mnorden81/RC-Multiswitch-ESP32-S3/docs/Hardware-Beschreibung_C3_S3.docx

# RC-Multiswitch – Hardware-Beschreibung

Schaltboards mit ESP32-C3 SuperMini und ESP32-S3-Zero · Stand 18.10.2026

# 1. Überblick

Das RC-Multiswitch ist ein 8-kanaliges Schaltmodul für RC-Anwendungen (Licht, Zusatzfunktionen, Sound-Trigger). Die Kanäle werden über das CRSF-Protokoll (420 000 Baud) vom Empfänger angesteuert. Ein TBD62083APG (Nachfolger des ULN2803A) schaltet gegen Masse (Low-Side) Lasten mit 5–12 V; ein ESP32 übernimmt Protokoll, Logik und Konfiguration (WLAN-Web-UI, Lua-Script).

Es gibt zwei Platinen-Varianten mit identischem Schalt-Teil:

Merkmal | Variante C3 | Variante S3
Controller-Modul | ESP32-C3 SuperMini | Waveshare ESP32-S3-Zero
Kern / UARTs | 1× RISC-V, UART0 + UART1 | 2× Xtensa, UART0/1/2
CRSF-Anschlüsse | UART A (Eingang) + UART B (weiter) | UART A (Eingang) + UART B + UART C (weiter)
PWM-Kanäle (LEDC) | 6 (Ausgang 7/8 nur digital) | 8 (alle Ausgänge PWM-fähig)
Status-LED | keine steuerbare (Onboard-LED IO8 = UB_RX) | WS2812 an IO21 nutzbar
BOOT-Taster | IO9 (am Modul) | IO0 (am Modul)
Platinenstand | fertig (KiCad 9) | aus C3-Platine portiert, Leiterbahnen nicht vollständig (20 offene Verbindungen)

# 2. Gemeinsame Funktionen

- Schaltstufe: TBD62083APG (DIP-18, gesockelt; ein ULN2803A passt weiterhin, gleiche Pinbelegung), 8 Kanäle, Open-Drain gegen GND, max. 500 mA je Kanal, Summe ca. 1,5 A. Interne Freilaufdioden an COM → VLOAD.
- Lastversorgung: CN2 (JST PH, 2-polig), 5–12 V, als VLOAD an COM des Treibers U2 und auf J1. TVS-Diode D1 P6KE18A schützt vor Spannungsspitzen.
- Logikversorgung: +5 V vom UART-A-Stecker CN1 (Pin 2); das ESP-Modul wird darüber versorgt. +5 V wird an die weiterführenden UART-Stecker durchgereicht.
- Kontroll-LEDs: LED1–8 mit R1–R8 je Kanal vom Steuersignal gegen GND – leuchtet, wenn der Kanal aktiv ist. Die Werte von R1–R8 legt der Anwender fest; eine Empfehlung ist auf der Platine aufgedruckt.
- Ausgänge: J1 (2×8-Stiftleiste, 2,54 mm): ungerade Pins = OUT1…OUT8 (nach Serienwiderstand R9–R16, Wert vom Anwender), gerade Pins = VLOAD.
- CRSF-Kette: Module lassen sich per UART durchschleifen (UART A Eingang, B/C Ausgang), siehe Firmware-Spezifikation.

# 3. Steckerbelegung

UART-Stecker (JST GH 4-polig, vertikal SMD) – CN1 = UART A, J5 = UART B, J6 = UART C (nur S3)

Pin | CN1 (A, Eingang) | J5 / J6 (B / C, weiter)
1 | GND | GND
2 | +5 V (Versorgung ein) | +5 V (durchgereicht)
3 | RX (ESP empfängt, vom Empfänger-TX) | TX (ESP sendet zum nächsten Modul)
4 | TX (ESP sendet zum Empfänger-RX) | RX (ESP empfängt vom nächsten Modul)

CN2 – Lastversorgung (JST PH 2-polig, vertikal)

Pin | Signal
1 | GND
2 | VLOAD (+5…12 V)

J1 – Ausgänge (2×8, 2,54 mm) und Kanal-Zuordnung

Kanal | Signal | GPIO C3 | GPIO S3 | U2-IN | U2-OUT | R aus | J1-Pin | LED / R-LED
1 | S0 | IO0 | IO11 | U2.8 | U2.11 | R16 | J1.15 | LED1 / R1
2 | S1 | IO1 | IO4 | U2.7 | U2.12 | R15 | J1.13 | LED2 / R2
3 | S2 | IO2 | IO5 | U2.6 | U2.13 | R14 | J1.11 | LED3 / R3
4 | S3 | IO3 | IO6 | U2.5 | U2.14 | R13 | J1.9 | LED4 / R4
5 | S4 | IO4 | IO10 | U2.4 | U2.15 | R12 | J1.7 | LED5 / R5
6 | S5 | IO5 | IO9 | U2.3 | U2.16 | R11 | J1.5 | LED6 / R6
7 | S6 | IO6 | IO8 | U2.2 | U2.17 | R10 | J1.3 | LED7 / R7
8 | S7 | IO7 | IO7 | U2.1 | U2.18 | R9 | J1.1 | LED8 / R8

Die geraden J1-Pins (2, 4, … 16) führen VLOAD; so kann eine Last direkt zwischen J1-Pin „OUTk“ und dem benachbarten VLOAD-Pin angeschlossen werden (Kanal k → J1-Pin 17−2k).

# 4. Variante C3 (ESP32-C3 SuperMini)

GPIO-Belegung C3

Signal | GPIO | Modul-Pad | Funktion
S0 | IO0 | U1.1 | Schaltausgang (Treiber-Eingang + LED) 1
S1 | IO1 | U1.2 | Schaltausgang (Treiber-Eingang + LED) 2
S2 | IO2 | U1.3 | Schaltausgang (Treiber-Eingang + LED) 3
S3 | IO3 | U1.4 | Schaltausgang (Treiber-Eingang + LED) 4
S4 | IO4 | U1.5 | Schaltausgang (Treiber-Eingang + LED) 5
S5 | IO5 | U1.9 | Schaltausgang (Treiber-Eingang + LED) 6
S6 | IO6 | U1.10 | Schaltausgang (Treiber-Eingang + LED) 7
S7 | IO7 | U1.11 | Schaltausgang (Treiber-Eingang + LED) 8
UA_RX | IO20 | U1.15 | CRSF-UART A – RX
UA_TX | IO21 | U1.16 | CRSF-UART A – TX
UB_TX | IO10 | U1.14 | CRSF-UART B – TX
UB_RX | IO8 | U1.12 | CRSF-UART B – RX

Stückliste C3

Referenz | Anz. | Wert | Footprint
CN1 | 1 | UART A | JST_GH_BM04B-GHS-TBT_1x04-1MP_P1.25mm_Vertical
CN2 | 1 | 5-12V | JST_PH_B2B-PH-K_1x02_P2.00mm_Vertical
D1 | 1 | P6KE18A | D_DO-15_P12.70mm_Horizontal
J1 | 1 | Ausgaenge | PinHeader_2x08_P2.54mm_Vertical
J5 | 1 | UART B | JST_GH_BM04B-GHS-TBT_1x04-1MP_P1.25mm_Vertical
LED1–LED8 | 8 | LED | LED_D3.0mm
R1–R16 | 16 | vom Anwender | R_Axial_DIN0207_L6.3mm_D2.5mm_P7.62mm_Horizontal
U1 | 1 | ESP32-C3 SuperMini | ESP32-C3-SuperMini_THT
U2 | 1 | TBD62083APG | DIP-18_W7.62mm_Socket

## Besonderheiten C3

- Nur 6 LEDC-Kanäle: Ausgang 7 und 8 (IO6/IO7) können nur digital schalten bzw. softwareseitig getaktet werden.
- UART A = UART0-Standardpins (IO20 RX / IO21 TX): das Boot-Log des ROM erscheint kurz auf IO21 (UA_TX). Debug-Ausgaben der Firmware daher über USB-CDC.
- Onboard-LED (IO8) ist zugleich UB_RX – sie flackert mit UART-B-Daten und ist als Status-LED nicht verwendbar.
- Strapping-Pins: IO2 (Kanal 3), IO8 (UB_RX), IO9 (BOOT). Beim Reset sollten IO8 und IO9 high sein; IO2-Beschaltung (LED + Treiber-Eingang nach GND) beim ersten Test prüfen.
- Einkernig: CRSF-Verarbeitung, Weiterleitung und WLAN laufen auf demselben Kern.

# 5. Variante S3 (Waveshare ESP32-S3-Zero)

GPIO-Belegung S3

Signal | GPIO | Modul-Pad | Funktion
S0 | IO11 | U1.14 | Schaltausgang (Treiber-Eingang + LED) 1
S1 | IO4 | U1.7 | Schaltausgang (Treiber-Eingang + LED) 2
S2 | IO5 | U1.8 | Schaltausgang (Treiber-Eingang + LED) 3
S3 | IO6 | U1.9 | Schaltausgang (Treiber-Eingang + LED) 4
S4 | IO10 | U1.15 | Schaltausgang (Treiber-Eingang + LED) 5
S5 | IO9 | U1.16 | Schaltausgang (Treiber-Eingang + LED) 6
S6 | IO8 | U1.17 | Schaltausgang (Treiber-Eingang + LED) 7
S7 | IO7 | U1.18 | Schaltausgang (Treiber-Eingang + LED) 8
UA_RX | IO44 | U1.11 | CRSF-UART A – RX
UA_TX | IO43 | U1.10 | CRSF-UART A – TX
UB_TX | IO13 | U1.12 | CRSF-UART B – TX
UB_RX | IO12 | U1.13 | CRSF-UART B – RX
UC_TX | IO2 | U1.5 | CRSF-UART C – TX
UC_RX | IO1 | U1.4 | CRSF-UART C – RX

Stückliste S3

Referenz | Anz. | Wert | Footprint
CN1 | 1 | UART A | JST_GH_BM04B-GHS-TBT_1x04-1MP_P1.25mm_Vertical
CN2 | 1 | 5-12V | JST_PH_B2B-PH-K_1x02_P2.00mm_Vertical
D1 | 1 | P6KE18A | D_DO-15_P12.70mm_Horizontal
J1 | 1 | Ausgaenge | PinHeader_2x08_P2.54mm_Vertical
J5 | 1 | UART B | JST_GH_BM04B-GHS-TBT_1x04-1MP_P1.25mm_Vertical
J6 | 1 | UART C | JST_GH_BM04B-GHS-TBT_1x04-1MP_P1.25mm_Vertical
LED1–LED8 | 8 | LED | LED_D3.0mm
R1–R16 | 16 | vom Anwender | R_Axial_DIN0207_L6.3mm_D2.5mm_P7.62mm_Horizontal
U1 | 1 | ESP32-S3-Zero | ESP32-S3-Zero_THT
U2 | 1 | TBD62083APG | DIP-18_W7.62mm_Socket

## Besonderheiten S3

- 8 LEDC-Kanäle, zwei Kerne, drei UARTs (A = UART0 auf IO43/IO44, B = IO13/IO12, C = IO2/IO1).
- WS2812-RGB-LED auf IO21 als Status-LED nutzbar (kein Konflikt mit der Belegung).
- UART A = IO43/IO44: das Boot-Log erscheint auf IO43 (UA_TX).
- Strapping-Pins IO0 (BOOT-Taster), IO3, IO45, IO46 sind nicht belegt – keine Konflikte.
- USB (IO19/IO20) bleibt frei für Programmierung und USB-CDC-Debug.

# 6. Dimensionierung

## Strom und Spannung

- Schaltstrom: max. 500 mA je Kanal, Summe aller Kanäle ca. 1,5 A. Der TBD62083APG verliert nur ca. 0,2–0,4 V; beim ULN2803A sind es ca. 1,1–1,3 V bei 350 mA (ca. 0,4 W je Kanal), dann bei mehreren Kanälen mit hoher Last Derating prüfen.
- Serienwiderstände R9–R16 im Ausgang: kein Wert vorgegeben. Der Anwender legt sie passend zu Verbraucher und Lastspannung (5–12 V) aus, Strom und Verlustleistung beachten. Für Lasten ohne Vorwiderstand (z. B. Relais) eine Drahtbrücke einsetzen.
- Kontroll-LEDs: R1–R8 legt der Anwender fest. Die Empfehlung für 3,3 V ist auf der Platine aufgedruckt (Rot/Gelb 270 Ω, Grün 220 Ω, Blau/Weiß 56 Ω, ca. 5 mA).
- CN2 (JST PH): ca. 2 A je Kontakt; Summenstrom aller Lasten darauf beachten.

# 7. Stand und offene Punkte

- C3-Platine: fertig, in KiCad 9. Steckerfootprints derzeit JST GH vertikal SMD (CN2: PH vertikal); horizontale Varianten sind nicht umgesetzt.
- S3-Platine: Bauteile und Netze aus der C3-Platine übernommen, J6 (UART C) ergänzt; die Leitungen an U1 sind neu verlegt; DRC wurde in dieser Umgebung nicht durchgeführt.
- ERC/DRC: nicht in KiCad 9 geprüft (nur Netzlisten-Abgleich). Vor Fertigung ERC/DRC in KiCad durchführen.
- Pad-Zuordnung der Module (SuperMini, S3-Zero) vor dem Bestücken gegen das tatsächliche Modul prüfen.

RC-Multiswitch – Hardware-Beschreibung – Seite
