mnorden81/RC-Multiswitch-ESP32-S3/hardware/gehaeuse/Gehaeuse3D_Vorschau_gewinkelt.html

# Gehäuse Schaltmodul S3, gewinkelte Stiftleiste

Version für eine gewinkelte Stiftleiste 2×8 (2,54 mm) an J1. Die Stecker der 8 Ausgänge kommen seitlich durch die rechte Wand, der Deckel ist über J1 geschlossen. Platine RC-Multiswitch-ESP32-S3 NEG oder POS (Waveshare ESP32-S3-Zero, TBD62083APG bzw. TBD62783APG). Alle Maße stammen aus der KiCad-Datei, die Bauteilhöhen sind Annahmen (unten markiert).

Außen71,9 × 61,6

Höhe19,6 mm

Platine66,5 × 50,6

Ziehen = drehen · Mausrad/zwei Finger = zoomen · rechte Maustaste = schieben

Zustand Zu Deckel ab Explosion

Ansicht Schräg Links (USB, A, 5-12 V) Hinten (B, C) Rechts (Ausgänge) Oben Unten

Zeigen Platine Deckel Deckel durchsichtig

## Öffnungen

Wo | Wofür | Größe B × H
links | USB-C des S3-Zero, außen mit Tasche für dicke Stecker | 12,0 × 7,6
links | CN1 UART A (Empfänger) | 11,5 × 7,0
links | CN2 Last 5-12 V | 7,5 × 7,0
hinten | J5 UART B und J6 UART C (eine gemeinsame Öffnung) | 22,8 × 7,0
rechts | J1 gewinkelte Stiftleiste 2×8, 8 Stecker 2-polig nebeneinander | 21,5 × 6,2
Deckel | Fenster über dem S3-Zero (BOOT, RESET, RGB-LED) | 24,5 × 19,0
Deckel | 8 Lichtlöcher Kontroll-LEDs | Ø 3,4
Deckel | 4 Lüftungsschlitze über dem Treiber U2 | 1,4 × 19

## Annahmen, bitte prüfen

- S3-Zero direkt eingelötet auf normaler Stiftleiste (Unterkante 2,5 mm über der Platine), so bestätigt. In einer Buchsenleiste säße er ca. 11 mm hoch, dann müssten USB-Loch und Innenhöhe angepasst werden.
- Gewinkelte Leiste nach KiCad-Footprint PinHeader_2x08_P2.54mm_Horizontal: Kunststoff 5,1 mm hoch, steht ca. 0,1 mm über die Platinenkante, Pins ragen ca. 3,4 mm aus der Außenwand. Gelötet wird in die vorhandenen Löcher, die Platine bleibt unverändert. Oben liegen die Ausgänge, unten die gemeinsame Reihe (NEG: VLOAD, POS: GND).
- Innenhöhe 11 mm wie bei der stehenden Version. Am höchsten ist jetzt der Treiber U2 im Sockel (ca. 8 mm).
- Befestigung der Platine: Sie hat keine Montagelöcher. Sie liegt ringsum auf einem 1,2 mm Rand und 2 Stützen. Der Deckel drückt sie mit 9 kleinen Rippen am Rand fest. Ohne Schrauben durch die Platine.
- Kontroll-LEDs (3 mm) sitzen ca. 6 mm unter dem Deckel. Durch die Löcher sieht man sie gut leuchten.
- Lage von BOOT, RESET und RGB-LED auf dem S3-Zero steht nicht in der KiCad-Datei. Deshalb ein Fenster über dem ganzen Modul.
- JST-PH-Stecker liegend, ca. 6 mm hoch. Öffnungen 0,8 mm größer als das Gehäuse der Buchse.

## Drucken und Montieren

- Material PETG oder PLA. 0,2 mm Schicht, 3 Wände, 20 % Füllung.
- Unterteil mit dem Boden aufs Bett, Deckel mit der Oberseite aufs Bett (STL ist schon gedreht). Keine Stützen nötig.
- Platine einfach einlegen, Stecker zeigen zu den Öffnungen links, hinten und rechts (J1). Die Stecker für J1 erst nach dem Einlegen aufstecken.
- Deckel: 4 × Blechschraube 2,5 × 8 (Senkkopf) in die Dome in der vorderen und hinteren Wand.
- Einbau ins Modell: 4 Laschen mit 3,4 mm Loch am Boden für Schrauben oder Kabelbinder.
- Wandstärke 2,2 mm, Boden und Deckel 2,0 mm, 3 mm Luft unter der Platine für Lötstellen.

## Dateien

- Gehaeuse_Unterteil_gewinkelt.stl / .step
- Gehaeuse_Deckel_gewinkelt.stl / .step
- gehaeuse.py --gewinkelt (Quelle, CadQuery, alle Maße als Parameter oben in der Datei)

STEP lässt sich in Fusion 360, FreeCAD oder KiCad öffnen und weiter ändern.
