mnorden81/RC-Multiswitch-ESP32-S3/hardware/gehaeuse/Gehaeuse3D_Vorschau.html

# Gehäuse Schaltmodul S3

Unterteil und Deckel für die Platine RC-Multiswitch-ESP32-S3 (Waveshare ESP32-S3-Zero, ULN2803A, 8 Ausgänge). Alle Maße stammen aus der KiCad-Datei, die Bauteilhöhen sind Annahmen (unten markiert).

Außen71,9 × 61,6

Höhe19,6 mm

Platine66,5 × 50,6

Ziehen = drehen · Mausrad/zwei Finger = zoomen · rechte Maustaste = schieben

Zustand Zu Deckel ab Explosion

Ansicht Schräg Links (USB, A, 5-12 V) Hinten (B, C) Oben Unten

Zeigen Platine Deckel Deckel durchsichtig

## Öffnungen

Wo | Wofür | Größe B × H
links | USB-C des S3-Zero, außen mit Tasche für dicke Stecker | 12,0 × 7,6
links | CN1 UART A (Empfänger) | 11,5 × 7,0
links | CN2 Last 5-12 V | 7,5 × 7,0
hinten | J5 UART B und J6 UART C (eine gemeinsame Öffnung) | 22,8 × 7,0
Deckel | J1 Stiftleiste 2×8, Stecker von oben | 6,9 × 22,1
Deckel | Fenster über dem S3-Zero (BOOT, RESET, RGB-LED) | 24,5 × 19,0
Deckel | 8 Lichtlöcher Kontroll-LEDs | Ø 3,4
Deckel | 4 Lüftungsschlitze über dem ULN2803A | 1,4 × 19

## Annahmen, bitte prüfen

- S3-Zero direkt eingelötet auf normaler Stiftleiste (Unterkante 2,5 mm über der Platine), so bestätigt. In einer Buchsenleiste säße er ca. 11 mm hoch, dann müssten USB-Loch und Innenhöhe angepasst werden.
- Innenhöhe 11 mm über der Platine. Am höchsten sind J1 (8,5 mm) und der ULN2803A im Sockel (ca. 8 mm).
- Befestigung der Platine: Sie hat keine Montagelöcher. Sie liegt ringsum auf einem 1,2 mm Rand und 2 Stützen. Der Deckel drückt sie mit 10 kleinen Rippen am Rand fest. Ohne Schrauben durch die Platine.
- Kontroll-LEDs (3 mm) sitzen ca. 6 mm unter dem Deckel. Durch die Löcher sieht man sie gut leuchten.
- Lage von BOOT, RESET und RGB-LED auf dem S3-Zero steht nicht in der KiCad-Datei. Deshalb ein Fenster über dem ganzen Modul.
- JST-PH-Stecker liegend, ca. 6 mm hoch. Öffnungen 0,8 mm größer als das Gehäuse der Buchse.

## Drucken und Montieren

- Material PETG oder PLA. 0,2 mm Schicht, 3 Wände, 20 % Füllung.
- Unterteil mit dem Boden aufs Bett, Deckel mit der Oberseite aufs Bett (STL ist schon gedreht). Keine Stützen nötig.
- Platine einfach einlegen, Stecker zeigen zu den Öffnungen links und hinten.
- Deckel: 4 × Blechschraube 2,5 × 8 (Senkkopf) in die Dome in der vorderen und hinteren Wand.
- Einbau ins Modell: 4 Laschen mit 3,4 mm Loch am Boden für Schrauben oder Kabelbinder.
- Wandstärke 2,2 mm, Boden und Deckel 2,0 mm, 3 mm Luft unter der Platine für Lötstellen.

## Dateien

- Gehaeuse_Unterteil.stl / .step
- Gehaeuse_Deckel.stl / .step
- gehaeuse.py (Quelle, CadQuery, alle Maße als Parameter oben in der Datei)

STEP lässt sich in Fusion 360, FreeCAD oder KiCad öffnen und weiter ändern.
