mnorden81/RC-Multiswitch-ESP32-S3/hardware/gehaeuse/Gehaeuse_Unterteil_gewinkelt.step

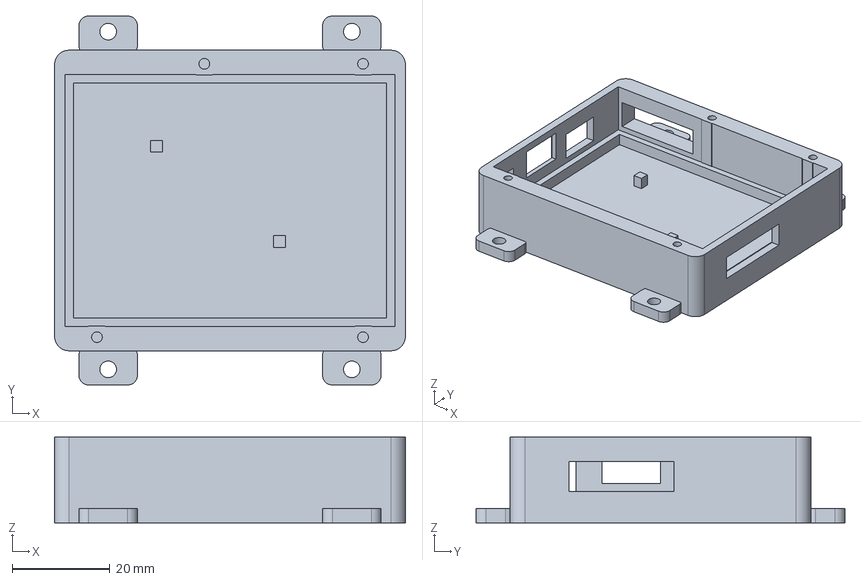
[picture p3: CAD file, 2026-10-30]
hardware/gehaeuse/Gehaeuse_Unterteil_gewinkelt.step
71.9 x 75.6 x 17.6 mm
