mnorden81/RC-Multiswitch-ESP32-S3/hardware/gehaeuse/Gehaeuse_Deckel_gewinkelt.step

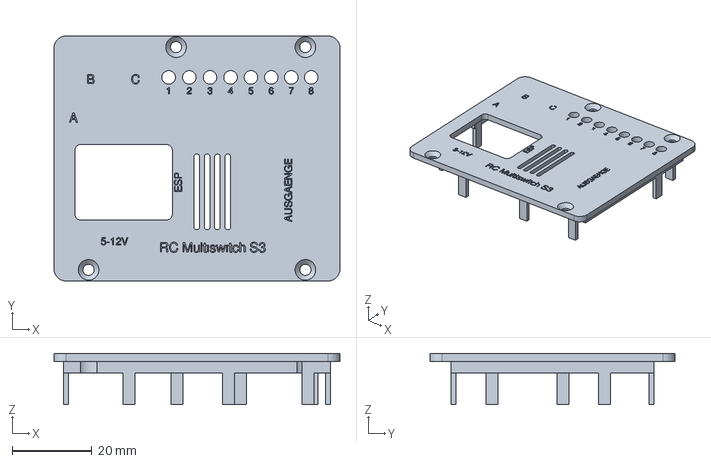
[picture p4: CAD file, 2026-10-30]
hardware/gehaeuse/Gehaeuse_Deckel_gewinkelt.step
71.9 x 61.6 x 12.9 mm
