mnorden81/RC-Multiswitch-ESP32-S3/(list of files, cad)

Other CAD files:
hardware/gehaeuse/Gehaeuse_Deckel.step
hardware/gehaeuse/Gehaeuse_Unterteil.step
hardware/gehaeuse/Gehaeuse_Deckel.stl
hardware/gehaeuse/Gehaeuse_Deckel_gewinkelt.stl
hardware/gehaeuse/Gehaeuse_Unterteil.stl
hardware/gehaeuse/Gehaeuse_Unterteil_gewinkelt.stl
