mnorden81/RC-Multiswitch-ESP32-S3/firmware/RC_Multiswitch/src/RC_Common/CRSF_ESP32/crsf_esp32.cpp

#include "crsf_esp32.h"

// serial_data/linkStats/info sind private Member der CRSF-Klasse (siehe
// crsf_esp32.h) statt globaler Variablen hier - noetig, damit eine zweite
// CRSF-Instanz (Port B) nicht den Haupt-Bus (Port A) mitbenutzt/
// ueberschreibt. Alle Verwendungsstellen unten sind unqualifiziert und
// binden dadurch automatisch an das jeweilige Objekt.

#ifndef ARDUINO
// Host-Ersatz fuer millis() und Serial (siehe crsf_platform.h)
static unsigned long crsfHostMillis = 0;
unsigned long millis() { return crsfHostMillis; }
void crsf_set_millis(unsigned long ms) { crsfHostMillis = ms; }
CrsfNullSerial Serial;
#endif

#define DEBUG_CRSF false
#define DEBUG_CRSF_TYPE false
#define DEBUG_CRSF_SEND false
#define DEBUG_CRSF_TELE false

CRSF::CRSF() {                  // Initialisierung
    deviceInfoReplyPending = 0; 
    deviceEntryReplyPending = 0;
    deviceReadReplyPending = 0;
    deviceWriteReplyPending = 0;
    deviceCommandReplyPending = 0;
}

unsigned char crc8tab[256] = {
    0x00, 0xD5, 0x7F, 0xAA, 0xFE, 0x2B, 0x81, 0x54, 0x29, 0xFC, 0x56, 0x83, 0xD7, 0x02, 0xA8, 0x7D,
    0x52, 0x87, 0x2D, 0xF8, 0xAC, 0x79, 0xD3, 0x06, 0x7B, 0xAE, 0x04, 0xD1, 0x85, 0x50, 0xFA, 0x2F,
    0xA4, 0x71, 0xDB, 0x0E, 0x5A, 0x8F, 0x25, 0xF0, 0x8D, 0x58, 0xF2, 0x27, 0x73, 0xA6, 0x0C, 0xD9,
    0xF6, 0x23, 0x89, 0x5C, 0x08, 0xDD, 0x77, 0xA2, 0xDF, 0x0A, 0xA0, 0x75, 0x21, 0xF4, 0x5E, 0x8B,
    0x9D, 0x48, 0xE2, 0x37, 0x63, 0xB6, 0x1C, 0xC9, 0xB4, 0x61, 0xCB, 0x1E, 0x4A, 0x9F, 0x35, 0xE0,
    0xCF, 0x1A, 0xB0, 0x65, 0x31, 0xE4, 0x4E, 0x9B, 0xE6, 0x33, 0x99, 0x4C, 0x18, 0xCD, 0x67, 0xB2,
    0x39, 0xEC, 0x46, 0x93, 0xC7, 0x12, 0xB8, 0x6D, 0x10, 0xC5, 0x6F, 0xBA, 0xEE, 0x3B, 0x91, 0x44,
    0x6B, 0xBE, 0x14, 0xC1, 0x95, 0x40, 0xEA, 0x3F, 0x42, 0x97, 0x3D, 0xE8, 0xBC, 0x69, 0xC3, 0x16,
    0xEF, 0x3A, 0x90, 0x45, 0x11, 0xC4, 0x6E, 0xBB, 0xC6, 0x13, 0xB9, 0x6C, 0x38, 0xED, 0x47, 0x92,
    0xBD, 0x68, 0xC2, 0x17, 0x43, 0x96, 0x3C, 0xE9, 0x94, 0x41, 0xEB, 0x3E, 0x6A, 0xBF, 0x15, 0xC0,
    0x4B, 0x9E, 0x34, 0xE1, 0xB5, 0x60, 0xCA, 0x1F, 0x62, 0xB7, 0x1D, 0xC8, 0x9C, 0x49, 0xE3, 0x36,
    0x19, 0xCC, 0x66, 0xB3, 0xE7, 0x32, 0x98, 0x4D, 0x30, 0xE5, 0x4F, 0x9A, 0xCE, 0x1B, 0xB1, 0x64,
    0x72, 0xA7, 0x0D, 0xD8, 0x8C, 0x59, 0xF3, 0x26, 0x5B, 0x8E, 0x24, 0xF1, 0xA5, 0x70, 0xDA, 0x0F,
    0x20, 0xF5, 0x5F, 0x8A, 0xDE, 0x0B, 0xA1, 0x74, 0x09, 0xDC, 0x76, 0xA3, 0xF7, 0x22, 0x88, 0x5D,
    0xD6, 0x03, 0xA9, 0x7C, 0x28, 0xFD, 0x57, 0x82, 0xFF, 0x2A, 0x80, 0x55, 0x01, 0xD4, 0x7E, 0xAB,
    0x84, 0x51, 0xFB, 0x2E, 0x7A, 0xAF, 0x05, 0xD0, 0xAD, 0x78, 0xD2, 0x07, 0x53, 0x86, 0x2C, 0xF9};

// Polynom 0xBA, Tabelle aus der CRSF-Spezifikation (identisch mit der
// WM-Firmware, wmucpp include_stm32/crc.h). Die fruehere Tabelle passte zu
// keinem Polynom.
const uint8_t crc8_ba_tab[256] = {
    0x00, 0xBA, 0xCE, 0x74, 0x26, 0x9C, 0xE8, 0x52, 0x4C, 0xF6, 0x82, 0x38, 0x6A, 0xD0, 0xA4, 0x1E,
    0x98, 0x22, 0x56, 0xEC, 0xBE, 0x04, 0x70, 0xCA, 0xD4, 0x6E, 0x1A, 0xA0, 0xF2, 0x48, 0x3C, 0x86,
    0x8A, 0x30, 0x44, 0xFE, 0xAC, 0x16, 0x62, 0xD8, 0xC6, 0x7C, 0x08, 0xB2, 0xE0, 0x5A, 0x2E, 0x94,
    0x12, 0xA8, 0xDC, 0x66, 0x34, 0x8E, 0xFA, 0x40, 0x5E, 0xE4, 0x90, 0x2A, 0x78, 0xC2, 0xB6, 0x0C,
    0xAE, 0x14, 0x60, 0xDA, 0x88, 0x32, 0x46, 0xFC, 0xE2, 0x58, 0x2C, 0x96, 0xC4, 0x7E, 0x0A, 0xB0,
    0x36, 0x8C, 0xF8, 0x42, 0x10, 0xAA, 0xDE, 0x64, 0x7A, 0xC0, 0xB4, 0x0E, 0x5C, 0xE6, 0x92, 0x28,
    0x24, 0x9E, 0xEA, 0x50, 0x02, 0xB8, 0xCC, 0x76, 0x68, 0xD2, 0xA6, 0x1C, 0x4E, 0xF4, 0x80, 0x3A,
    0xBC, 0x06, 0x72, 0xC8, 0x9A, 0x20, 0x54, 0xEE, 0xF0, 0x4A, 0x3E, 0x84, 0xD6, 0x6C, 0x18, 0xA2,
    0xE6, 0x5C, 0x28, 0x92, 0xC0, 0x7A, 0x0E, 0xB4, 0xAA, 0x10, 0x64, 0xDE, 0x8C, 0x36, 0x42, 0xF8,
    0x7E, 0xC4, 0xB0, 0x0A, 0x58, 0xE2, 0x96, 0x2C, 0x32, 0x88, 0xFC, 0x46, 0x14, 0xAE, 0xDA, 0x60,
    0x6C, 0xD6, 0xA2, 0x18, 0x4A, 0xF0, 0x84, 0x3E, 0x20, 0x9A, 0xEE, 0x54, 0x06, 0xBC, 0xC8, 0x72,
    0xF4, 0x4E, 0x3A, 0x80, 0xD2, 0x68, 0x1C, 0xA6, 0xB8, 0x02, 0x76, 0xCC, 0x9E, 0x24, 0x50, 0xEA,
    0x48, 0xF2, 0x86, 0x3C, 0x6E, 0xD4, 0xA0, 0x1A, 0x04, 0xBE, 0xCA, 0x70, 0x22, 0x98, 0xEC, 0x56,
    0xD0, 0x6A, 0x1E, 0xA4, 0xF6, 0x4C, 0x38, 0x82, 0x9C, 0x26, 0x52, 0xE8, 0xBA, 0x00, 0x74, 0xCE,
    0xC2, 0x78, 0x0C, 0xB6, 0xE4, 0x5E, 0x2A, 0x90, 0x8E, 0x34, 0x40, 0xFA, 0xA8, 0x12, 0x66, 0xDC,
    0x5A, 0xE0, 0x94, 0x2E, 0x7C, 0xC6, 0xB2, 0x08, 0x16, 0xAC, 0xD8, 0x62, 0x30, 0x8A, 0xFE, 0x44};
// Calculate checksum
uint8_t crc8(const uint8_t * ptr, uint8_t len)
{
  uint8_t crc = 0;
  for (uint8_t i=0; i<len; i++)
      crc = crc8tab[crc ^ *ptr++];
  return crc;
}

uint8_t crc8_ba(const uint8_t* ptr, size_t len, uint8_t init) {
    uint8_t crc = init;
    for (size_t i = 0; i < len; ++i) {
        crc = crc8_ba_tab[crc ^ ptr[i]];
    }
    return crc;
}

const int   Kl = 100;       // linearity constant
const float Kr = 0.026;     // range constant

int8_t sign(int32_t v) {
    if (v > 0) return 1;
    if (v < 0) return -1;
    return 0;
}

int8_t get_vertical_speed_packed(int16_t vertical_speed_cm_s) {
    if (vertical_speed_cm_s == 0)
        return 0;

    float x = log(abs(vertical_speed_cm_s) / (float)Kl + 1) / Kr;
    int8_t packed = (int8_t)x;

    return packed * sign(vertical_speed_cm_s);
}

uint16_t get_altitude_packed (int32_t altitude_dm){
    enum
    {
        ALT_MIN_DM = 10000,                     //minimum altitude in dm
        ALT_THRESHOLD_DM = 0x8000 - ALT_MIN_DM, //altitude of precision
                                                // changing in dm
        ALT_MAX_DM = 0x7ffe * 10 - 5,           //maximum altitude in dm
    };

    if(altitude_dm < -ALT_MIN_DM)               //less than minimum altitude
        return 0;                               //minimum
    if(altitude_dm > ALT_MAX_DM)                //more than maximum
        return 0xfffe;                          //maximum
    if(altitude_dm < ALT_THRESHOLD_DM)          //dm-resolution range
        return altitude_dm + ALT_MIN_DM;
    return ((altitude_dm + 5) / 10) | 0x8000;   //meter-resolution range
}

// Extract channels from CRSF buffer
void CRSF::updateChannels() {
      channels[0] = ((crfs_buffer[3] | crfs_buffer[4] << 8) & CHANNEL_MASK);
      channels[1] = ((crfs_buffer[4] >> 3 | crfs_buffer[5] << 5) & CHANNEL_MASK);
      channels[2] = ((crfs_buffer[5] >> 6 | crfs_buffer[6] << 2 | crfs_buffer[7] << 10) & CHANNEL_MASK);
      channels[3] = ((crfs_buffer[7] >> 1 | crfs_buffer[8] << 7) & CHANNEL_MASK);
      channels[4] = ((crfs_buffer[8] >> 4 | crfs_buffer[9] << 4) & CHANNEL_MASK);
      channels[5] = ((crfs_buffer[9] >> 7 | crfs_buffer[10] << 1 | crfs_buffer[11] << 9) & CHANNEL_MASK);
      channels[6] = ((crfs_buffer[11] >> 2 | crfs_buffer[12] << 6) & CHANNEL_MASK);
      channels[7] = ((crfs_buffer[12] >> 5 | crfs_buffer[13] << 3) & CHANNEL_MASK);
      channels[8] = ((crfs_buffer[14] | crfs_buffer[15] << 8) & CHANNEL_MASK);
      channels[9] = ((crfs_buffer[15] >> 3 | crfs_buffer[16] << 5) & CHANNEL_MASK);
      channels[10] = ((crfs_buffer[16] >> 6 | crfs_buffer[17] << 2 | crfs_buffer[18] << 10) & CHANNEL_MASK);
      channels[11] = ((crfs_buffer[18] >> 1 | crfs_buffer[19] << 7) & CHANNEL_MASK);
      channels[12] = ((crfs_buffer[19] >> 4 | crfs_buffer[20] << 4) & CHANNEL_MASK);
      channels[13] = ((crfs_buffer[20] >> 7 | crfs_buffer[21] << 1 | crfs_buffer[22] << 9) & CHANNEL_MASK);
      channels[14] = ((crfs_buffer[22] >> 2 | crfs_buffer[23] << 6) & CHANNEL_MASK);
      channels[15] = ((crfs_buffer[23] >> 5 | crfs_buffer[24] << 3) & CHANNEL_MASK);
}

void CRSF::updateLink_Statistics() {
    // Reihenfolge laut CRSF-Spezifikation (0x14). Vor v1.0.0 fehlte
    // up_rssi_ant2, dadurch waren alle Felder ab LQ um ein Byte verschoben.
    linkStats.uplinkRSSI     = crfs_buffer[3];
    linkStats.uplinkRSSI2    = crfs_buffer[4];
    linkStats.uplinkLQ       = crfs_buffer[5];
    linkStats.uplinkSNR      = (int8_t)crfs_buffer[6];
    linkStats.activeAntenna  = crfs_buffer[7];
    linkStats.rfMode         = crfs_buffer[8];
    linkStats.txPower        = crfs_buffer[9];
    linkStats.downlinkRSSI   = crfs_buffer[10];
    linkStats.downlinkLQ     = crfs_buffer[11];
    linkStats.downlinkSNR    = (int8_t)crfs_buffer[12];
    linkStats.lastUpdate     = millis();

/*
    Serial.println("📡 LinkStatistics empfangen:");
    Serial.printf("  ➤ Uplink     : RSSI %ddBm | LQ %d%% | SNR %ddB\n", linkStats.uplinkRSSI, linkStats.uplinkLQ, linkStats.uplinkSNR);
    Serial.printf("  ➤ Downlink   : RSSI %ddBm | LQ %d%% | SNR %ddB\n", linkStats.downlinkRSSI, linkStats.downlinkLQ, linkStats.downlinkSNR);
    Serial.printf("  ➤ TX Power   : %dmW\n", linkStats.txPower);
    Serial.printf("  ➤ RF Mode    : %d\n", linkStats.rfMode);
    Serial.printf("  ➤ Antenne    : %d\n", linkStats.activeAntenna);
    Serial.printf("  ➤ Letztes Update: %lu ms\n", linkStats.lastUpdate);
*/    
}

void CRSF::updateDevice_Info() {

uint8_t frameLength = crfs_buffer[1];         // Länge ab crfs_buffer[2]
// "frameLength - 1" koennte bei frameLength 0 oder 1 unterlaufen (im
// Normalbetrieb durch die Laengenpruefung in read_packets() ausgeschlossen,
// aber diese Funktion soll auch fuer sich alleine sicher sein). Rechnung
// deshalb komplett in signed int statt uint8_t, damit kein Zwischenschritt
// umlaufen kann.
int payloadLength = (int)frameLength - 1; // ohne Typ-Byte
int fixedFields = 4 * 3 + 2;              // 3 × uint32_t + 2 × uint8_t = 14
if (payloadLength < fixedFields + 1) return; // zu kurz, verwerfen
int nameLength = payloadLength - fixedFields - 1;

if (nameLength > 31) nameLength = 31;   // Sicherheit

memcpy(info.deviceName, &crfs_buffer[5], nameLength);
info.deviceName[nameLength] = '\0';     // Null-terminieren

uint8_t i = 3 + nameLength;
info.serialNumber           = (crfs_buffer[i] << 24) | (crfs_buffer[i+1] << 16) | (crfs_buffer[i+2] << 8) | crfs_buffer[i+3];
info.hardwareID             = (crfs_buffer[i+4] << 24) | (crfs_buffer[i+5] << 16) | (crfs_buffer[i+6] << 8) | crfs_buffer[i+7];
info.firmwareID             = (crfs_buffer[i+8] << 24) | (crfs_buffer[i+9] << 16) | (crfs_buffer[i+10] << 8) | crfs_buffer[i+11];
info.parametersTotal        = crfs_buffer[i+12];
info.parameterVersionNumber = crfs_buffer[i+13];
/*
Serial.println("📦 Erweiterte Device Info:");
Serial.printf("  ➤ Name             : %s (%d Bytes)\n", info.deviceName, nameLength);
Serial.printf("  ➤ Serial Number    : %08X\n", info.serialNumber);
Serial.printf("  ➤ Hardware ID      : %08X\n", info.hardwareID);
Serial.printf("  ➤ Firmware ID      : %08X\n", info.firmwareID);
Serial.printf("  ➤ Parameter Count  : %d\n", info.parametersTotal);
Serial.printf("  ➤ Param Version    : %d\n", info.parameterVersionNumber);
*/
}

void CRSF::setDeviceInfoReplyPending(bool newValue) {
    deviceInfoReplyPending = newValue;
}

void CRSF::setDeviceEntryReplyPending(bool newValue) {
    deviceEntryReplyPending = newValue;
}

void CRSF::setDeviceReadReplyPending(bool newValue) {
    deviceReadReplyPending = newValue;
}

void CRSF::setDeviceWriteReplyPending(bool newValue) {
    deviceWriteReplyPending = newValue;
}

void CRSF::setDeviceCommandReplyPending(bool newValue) {
    deviceCommandReplyPending = newValue;
}

void CRSF::set_crsf_channel(uint8_t ch, uint16_t value) {
    if (ch < CRSF_MAX_CHANNELS) 
        channels[ch] = value;
}

#if defined(ARDUINO) && defined(ESP32)   // nur ESP32 (RP2350-Auszug nutzt den Rest, seit 1.3.0)
void CRSF::init_crsf(HardwareSerial *serialPort, uint8_t rxPin, uint8_t txPin, uint32_t baud) {
  // serialPort wird tatsaechlich verwendet (nicht hart "&Serial2"), damit
  // eine zweite Instanz nicht ebenfalls auf Serial2 landet. nullptr faellt
  // auf Serial1 zurueck (gibt es auf allen ESP32-Varianten, Serial2 nicht).
  HardwareSerial* port = serialPort ? serialPort : &Serial1;
  // Groessere Puffer (vor begin()), damit weitergeleitete Frames nicht
  // blockieren und bei kurzen Loop-Pausen (Web-UI) nichts verloren geht.
  port->setRxBufferSize(CRSF_UART_RX_BUF);
  port->setTxBufferSize(CRSF_UART_TX_BUF);
  port->begin(baud, SERIAL_8N1, rxPin, txPin);
  serial_data = port;
  portA_.ser = port;
#if DEBUG_CRSF
  Serial.println("Initializing CRSF...");
#endif
}
#endif

void CRSF::print_channels() {
    Serial.print("Channels: ");
    for (int i = 0; i < CRSF_MAX_CHANNELS; i++) {
        Serial.print(channels[i]);
        Serial.print(" ");
    }
    Serial.println();
}

// New packet CRSF Data
void CRSF::crsfDataReceive() {
    uint8_t TYPE = crfs_buffer[2];

    switch (TYPE) {
        case CRSF_FRAMETYPE_LINK_STATISTICS:
            updateLink_Statistics();
#if DEBUG_CRSF_TYPE        
            //Serial.println("📤 CRSF_FRAMETYPE_LINK_STATISTICS");
#endif             
            break;

        case CRSF_FRAMETYPE_RC_CHANNELS_PACKED:
            updateChannels();
            lastRcFrameMs = millis();
#if DEBUG_CRSF_TYPE
            //Serial.println("📤 CRSF_FRAMETYPE_RC_CHANNELS_PACKED");
#endif             
            break;

        case CRSF_FRAMETYPE_DEVICE_PING:
            if (crfs_buffer[3] != deviceAddress &&
                crfs_buffer[3] != CRSF_ADDRESS_BROADCAST) break;
            devicePingsRx++;
            pingSource = crfs_buffer[4];  // Source des PING merken
            pingReceivedTime = millis();  // Zeitpunkt fuer Slot-Delay (Antwort erst im eigenen Zeit-Slot)
            deviceInfoReplyPending = true; 
#if DEBUG_CRSF_TYPE      
            Serial.print("📤 CRSF_FRAMETYPE_DEVICE_PING Destination: ");
            Serial.print(crfs_buffer[3], HEX);
            Serial.print(" Source: ");
            Serial.println(crfs_buffer[4], HEX);
#endif             
            break;   

        case CRSF_FRAMETYPE_DEVICE_INFO:
            // DEVICE_INFO von anderen Geraeten nicht beantworten (nur PING)
            //Serial.print("📤 CRSF_FRAMETYPE_DEVICE_INFO Destination: ");
            updateDevice_Info();
            break;  

        case CRSF_FRAMETYPE_PARAMETER_SETTINGS_ENTRY:
            deviceEntryReplyPending = true;
#if DEBUG_CRSF_TYPE 
            Serial.println("📤 CRSF_FRAMETYPE_PARAMETER_SETTINGS_ENTRY Destination: ");
            Serial.print(crfs_buffer[3], HEX);
            Serial.print(" Source: ");
            Serial.print(crfs_buffer[4], HEX);
            Serial.print(" ID: ");
            Serial.println(crfs_buffer[5]);
#endif             
            break; 

        case CRSF_FRAMETYPE_PARAMETER_READ:
            // Nur verarbeiten wenn wir die Zieladresse sind
            if (crfs_buffer[3] != deviceAddress &&
                crfs_buffer[3] != CRSF_ADDRESS_BROADCAST) break;
            paramReadsRx++;
            paramReadSource = crfs_buffer[4];  // Source = Destination fuer Antwort
            paramReadIndex = crfs_buffer[5];  // angefragter Parameter
            // Chunk-Nummer (seit 1.2.1): lange Eintraege fragt der Sender
            // Chunk fuer Chunk ab, geantwortet wird nur mit diesem Chunk.
            paramReadChunk = crfs_buffer[1] >= 6 ? crfs_buffer[6] : 0;
            deviceReadReplyPending = true;
#if DEBUG_CRSF_TYPE 
            Serial.print("📤 CRSF_FRAMETYPE_PARAMETER_READ Destination: ");
            Serial.print(crfs_buffer[3], HEX);
            Serial.print(" Source: ");
            Serial.print(crfs_buffer[4], HEX);
            Serial.print(" ID: ");
            Serial.println(crfs_buffer[5]);
#endif             
            break; 

        case CRSF_FRAMETYPE_PARAMETER_WRITE:
            if (crfs_buffer[3] != deviceAddress &&
                crfs_buffer[3] != CRSF_ADDRESS_BROADCAST) break;
            paramWritesRx++;
            paramReadChunk = 0;   // Antwort auf ein Schreiben beginnt bei Chunk 0
            paramWriteIndex = crfs_buffer[5];  // Parameter-Index
            paramWriteValue = crfs_buffer[6];  // Wert
            deviceWriteReplyPending = true;
#if DEBUG_CRSF_TYPE 
            Serial.print("📤 CRSF_FRAMETYPE_PARAMETER_WRITE Destination: ");
            Serial.print(crfs_buffer[3], HEX);
            Serial.print(" Source: ");
            Serial.print(crfs_buffer[4], HEX);
            Serial.print(" ID: ");
            Serial.print(crfs_buffer[5], HEX);
            Serial.print(" Value: ");
            Serial.println(crfs_buffer[6], HEX);
#endif             
            break;    

        case CRSF_FRAMETYPE_COMMAND:
            // Zieladresse wird genauso geprueft wie bei PING/PARAMETER_READ/
            // WRITE, damit nicht jedes Kommando auf dem Bus (auch an ein
            // anderes Geraet adressiert) hier eine Aktion ausloest.
            // CRSF_ADDRESS_BROADCAST bleibt erlaubt: das WM-Multiswitch-Protokoll
            // (MWset/MWset4/MWset4m) adressiert bewusst per Broadcast und filtert
            // erst auf Payload-Ebene nach der eigenen Modul-Adresse (siehe
            // einkanalFunctionCRSF() in der .ino).
            if (crfs_buffer[3] != deviceAddress &&
                crfs_buffer[3] != CRSF_ADDRESS_BROADCAST) break;
            deviceCommandReplyPending = true;
            memcpy(cmdBuffer, crfs_buffer, CRSF_PACKET_SIZE); // Kommando sofort sichern (gegen Ueberschreiben durch Folge-Frames)
#if DEBUG_CRSF_TYPE 
            Serial.printf("RX CMD D:%02X S:%02X W:%02X C:%02X A:%02X ch:%02X d:%02X\n",
                crfs_buffer[3],crfs_buffer[4],crfs_buffer[5],
                crfs_buffer[6],crfs_buffer[7],crfs_buffer[8],crfs_buffer[9]);
#endif             
            break;    
         
    }
}

void CRSF::send_packets(byte* buffer, size_t length, uint8_t debug) {
    if (debug) 
    {
        Serial.print("TX-Buffer: ");
        for (size_t i = 0; i < length; i++) {
            Serial.print(buffer[i], HEX); // Ausgabe in Hexadezimalformat
            Serial.print(" ");
        }
        Serial.println("");
    }
    serial_data->write(buffer, length);
    // (txEchoBytes entfernt - Full-Duplex, kein Echo)
    // flush() entfernt: wuerde Loop blockieren wenn LUA viele Pakete sendet
}

// Read CRSF packets from serial port
void CRSF::read_packets(uint8_t debug) {
    // byte_index/length sind Referenzen auf Member: der Zustand ueberlebt
    // das Ende dieses Aufrufs, ein halb empfangener Frame wird beim
    // naechsten Aufruf vervollstaendigt (vorher lokale Variablen - der
    // Rest des Frames wurde dann als neuer Frame gelesen und verworfen).
    uint8_t data;
    uint8_t& byte_index = rxIndex;
    uint8_t& length = rxLength;

    while (serial_data->available() > 0) {
        data = serial_data->read();
        rawBytesRx++;

        // Akzeptiere alle bekannten CRSF-Sync-Bytes (inkl. 0xEE/TBS-Agent, 0xEF/ELRS-LUA)
        if (byte_index == 0) {
            if (data == CRSF_SYNC_byte ||              // 0xC8
                data == CRSF_ADDRESS_RADIO_TRANSMITTER || // 0xEA
                data == CRSF_ADDRESS_CRSF_TRANSMITTER ||  // 0xEE
                data == CRSF_ADDRESS_ELRS_LUA ||          // 0xEF
                data == CRSF_ADDRESS_CRSF_RECEIVER ||     // 0xEC
                data == CRSF_ADDRESS_BROADCAST) {         // 0x00
                crfs_buffer[byte_index++] = data;
            }
            continue;
        }

        if (byte_index == 1) {
            length = data;
            // Laenge wird validiert, BEVOR sie fuer die CRC-Berechnung
            // (length-1) und die Frame-Vervollstaendigung (byte_index==length+1)
            // benutzt wird. Ohne diese Pruefung liest crc8() bei length==0 durch
            // den Unsigned-Unterlauf (0-1 -> 255) 255 Byte aus einem 64-Byte-
            // Puffer, und zu grosse Laengen liessen den Parser nie resynchen.
            // Gueltiger Bereich: mind. 2 (Typ+CRC), max. CRSF_PACKET_SIZE-2
            // (Sync+Len+Payload+CRC muessen noch reinpassen).
            if (length < 2 || length > (CRSF_PACKET_SIZE - 2)) {
                byte_index = 0; // verwerfen, auf naechstes Sync-Byte resynchen
                continue;
            }
            crfs_buffer[byte_index++] = data;
            continue;
        }

        if (byte_index == length + 1) {
            crfs_buffer[byte_index++] = data;
            if (data == crc8(&crfs_buffer[2], length - 1)) {
                // Das CRC-Byte ist an dieser Stelle bereits oben korrekt im
                // Puffer gespeichert - es wird hier bewusst kein zweites Mal
                // geschrieben.
                validFramesRx++;
                // Router: vor crsfDataReceive(), der Puffer ist noch unveraendert
                routeFromA(crfs_buffer, length + 2);
                crsfDataReceive();
                if (debug) {
                    Serial.print("RX-Buffer: ");
                    for (size_t i = 0; i < (size_t)(length + 2); i++) {
                        Serial.print(crfs_buffer[i], HEX); // Ausgabe in Hexadezimalformat
                        Serial.print(" ");
                    }
                    Serial.println("");
                }
            } else {
                crcErrorsRx++;
                // Bei laengerem Funkrauschen wuerde eine sofortige, unbedingte
                // "CRC Error"-Ausgabe je Fehler den Hauptloop mit vielen
                // Serial.println()-Aufrufen hintereinander blockieren. Der
                // Zaehler crcErrorsRx existiert schon (u.a. fuer die
                // Debug-Seite); hier nur eine gesammelte Zusammenfassung
                // hoechstens alle 2 Sekunden.
                static unsigned long lastCrcErrLog = 0;
                static uint32_t crcErrSinceLog = 0;
                crcErrSinceLog++;
                unsigned long nowMs = millis();
                if (nowMs - lastCrcErrLog >= 2000) {
                    Serial.printf("CRC Error (%u seit letzter Meldung, gesamt %u)\n",
                                  (unsigned)crcErrSinceLog, (unsigned)crcErrorsRx);
                    crcErrSinceLog = 0;
                    lastCrcErrLog = nowMs;
                }
            }
            byte_index = 0;
            continue;
        }
        if (byte_index < CRSF_PACKET_SIZE) {
            crfs_buffer[byte_index++] = data;
        } else {
            byte_index = 0;
        }
    }
}

// ════════════════════════════════════════════════════════════════════
//  Router fuer Modulketten (seit 1.1.0, aus RC-Multiswitch v4.01)
//  Store-and-Forward: nur vollstaendige Frames mit gueltiger CRC werden
//  unveraendert weitergegeben.
//    A -> B und C : alles ausser Extended-Frames an die eigene Adresse
//    B/C -> A     : alles
//    B <-> C      : nie
//  Frames ohne Extended-Header (Typ < 0x28, z.B. RC-Kanaele 0x16 und
//  Link-Statistik 0x14) haben keine Zieladresse und gehen immer weiter.
// ════════════════════════════════════════════════════════════════════
#if defined(ARDUINO) && defined(ESP32)   // nur ESP32 (RP2350-Auszug nutzt den Rest, seit 1.3.0)
void CRSF::init_router(HardwareSerial* portB, uint8_t bRx, uint8_t bTx,
                       HardwareSerial* portC, uint8_t cRx, uint8_t cTx,
                       uint32_t bBaud, uint32_t cBaud) {
    HardwareSerial* s[2]    = {portB, portC};
    uint8_t         rx[2]   = {bRx, cRx};
    uint8_t         tx[2]   = {bTx, cTx};
    uint32_t        baud[2] = {bBaud, cBaud};
    for (int i = 0; i < 2; i++) {
        if (!s[i]) continue;
        s[i]->setRxBufferSize(CRSF_UART_RX_BUF);
        s[i]->setTxBufferSize(CRSF_UART_TX_BUF);
        s[i]->begin(baud[i], SERIAL_8N1, rx[i], tx[i]);
    }
    attach_router_streams(portB, portC);
}
#endif

void CRSF::attach_router_streams(Stream* portB, Stream* portC) {
    portB_.ser = portB;
    portC_.ser = portC;
    routerActive = (portB_.ser || portC_.ser);
}

bool CRSF::isSyncByte(uint8_t b) {
    return b == CRSF_SYNC_byte || b == CRSF_ADDRESS_RADIO_TRANSMITTER ||
           b == CRSF_ADDRESS_CRSF_TRANSMITTER || b == CRSF_ADDRESS_ELRS_LUA ||
           b == CRSF_ADDRESS_CRSF_RECEIVER || b == CRSF_ADDRESS_BROADCAST;
}

// Gleicher Ablauf wie read_packets() fuer Port A
bool CRSF::parseByte(CrsfPort& p, uint8_t data) {
    if (p.rxIdx == 0) {
        if (isSyncByte(data)) p.rx[p.rxIdx++] = data;
        return false;
    }
    if (p.rxIdx == 1) {
        if (data < 2 || data > (CRSF_PACKET_SIZE - 2)) { p.rxIdx = 0; return false; }
        p.rxLen = data;
        p.rx[p.rxIdx++] = data;
        return false;
    }
    p.rx[p.rxIdx++] = data;
    if (p.rxIdx < p.rxLen + 2) return false;
    p.rxIdx = 0;
    if (data == crc8(&p.rx[2], p.rxLen - 1)) return true;
    downCrcErrors++;
    return false;
}

void CRSF::routeFromA(const uint8_t* f, uint8_t n) {
    if (!routerActive) return;
    uint8_t type = f[2];
    // Extended-Frame an die eigene Adresse: nur intern. Ausnahme 0xC8
    // (Adresse 8 = Flight-Controller/Sync), die gilt auf dem Bus als Broadcast.
    if (type >= 0x28 && n > 4 && f[3] == deviceAddress &&
        deviceAddress != CRSF_SYNC_byte) return;
    if (portB_.ser) enqueue(portB_, f, n);
    if (portC_.ser) enqueue(portC_, f, n);
    fwdDown++;
}

void CRSF::routeFromDown(CrsfPort& p) {
    while (p.ser->available() > 0) {
        if (!parseByte(p, (uint8_t)p.ser->read())) continue;
        uint8_t n = p.rxLen + 2;
        // Doppelte Adresse: ein Modul weiter hinten meldet unsere Adresse
        if (p.rx[2] == CRSF_FRAMETYPE_DEVICE_INFO && n > 5 && p.rx[4] == deviceAddress) {
            duplicateAddress = true;
            duplicatePorts |= (&p == &portC_) ? 2 : 1;
        }
        if (portA_.ser) enqueue(portA_, p.rx, n);
        fwdUp++;
    }
}

// Ganzen Frame senden oder einreihen - nie einen Teil-Frame schreiben.
void CRSF::enqueue(CrsfPort& p, const uint8_t* f, uint8_t n) {
    if (p.qCount == 0 && p.ser->availableForWrite() >= n) {
        p.ser->write(f, n);
        return;
    }
    if (p.qCount >= CRSF_ROUTER_QUEUE) {
        // Voll: aeltesten RC-Kanal-Frame verwerfen (Aktualitaet vor
        // Vollstaendigkeit). Ohne RC-Frame in der Schlange wird ein neuer
        // RC-Frame verworfen, alle anderen Frames verdraengen den aeltesten.
        int victim = -1;
        for (uint8_t i = 0; i < p.qCount; i++) {
            uint8_t k = (p.qHead + i) % CRSF_ROUTER_QUEUE;
            if (p.q[k][2] == CRSF_FRAMETYPE_RC_CHANNELS_PACKED) { victim = i; break; }
        }
        fwdDropped++;
        if (victim < 0) {
            if (f[2] == CRSF_FRAMETYPE_RC_CHANNELS_PACKED) return;
            victim = 0;
        }
        // Eintrag 'victim' entfernen, Rest nachruecken
        for (uint8_t i = victim; i + 1 < p.qCount; i++) {
            uint8_t a = (p.qHead + i) % CRSF_ROUTER_QUEUE;
            uint8_t b = (p.qHead + i + 1) % CRSF_ROUTER_QUEUE;
            memcpy(p.q[a], p.q[b], p.qLen[b]);
            p.qLen[a] = p.qLen[b];
        }
        p.qCount--;
    }
    uint8_t k = (p.qHead + p.qCount) % CRSF_ROUTER_QUEUE;
    memcpy(p.q[k], f, n);
    p.qLen[k] = n;
    p.qCount++;
}

void CRSF::serviceQueue(CrsfPort& p) {
    while (p.qCount > 0 && p.ser->availableForWrite() >= p.qLen[p.qHead]) {
        p.ser->write(p.q[p.qHead], p.qLen[p.qHead]);
        p.qHead = (p.qHead + 1) % CRSF_ROUTER_QUEUE;
        p.qCount--;
    }
}

void CRSF::route_packets() {
    if (!routerActive || !portA_.ser) return;
    if (portB_.ser) routeFromDown(portB_);
    if (portC_.ser) routeFromDown(portC_);
    serviceQueue(portA_);
    if (portB_.ser) serviceQueue(portB_);
    if (portC_.ser) serviceQueue(portC_);
}

void CRSF::send_rc_channels_packed() {

    // const uint8_t crc = crsf_crc8(&packet[2], CRSF_PACKET_SIZE-3);
    /*
     * Map 1000-2000 with middle at 1500 chanel values to
     * 173-1811 with middle at 992 S.BUS protocol requires
    */

    uint8_t len = 24;  
    uint8_t packet[64];
    // packet[0] = UART_SYNC; //Header
    packet[0] = CRSF_ADDRESS_CRSF_TRANSMITTER;   // sync ? OpenTX/EdgeTX sends the channels packet starting with 0xEE instead of 0xC8
    packet[1] = len;           // len
    packet[2] = CRSF_FRAMETYPE_RC_CHANNELS_PACKED;  // type
    packet[3] = (uint8_t)(channels[0] & 0x07FF);
    packet[4] = (uint8_t)((channels[0] & 0x07FF) >> 8 | (channels[1] & 0x07FF) << 3);
    packet[5] = (uint8_t)((channels[1] & 0x07FF) >> 5 | (channels[2] & 0x07FF) << 6);
    packet[6] = (uint8_t)((channels[2] & 0x07FF) >> 2);
    packet[7] = (uint8_t)((channels[2] & 0x07FF) >> 10 | (channels[3] & 0x07FF) << 1);
    packet[8] = (uint8_t)((channels[3] & 0x07FF) >> 7 | (channels[4] & 0x07FF) << 4);
    packet[9] = (uint8_t)((channels[4] & 0x07FF) >> 4 | (channels[5] & 0x07FF) << 7);
    packet[10] = (uint8_t)((channels[5] & 0x07FF) >> 1);
    packet[11] = (uint8_t)((channels[5] & 0x07FF) >> 9 | (channels[6] & 0x07FF) << 2);
    packet[12] = (uint8_t)((channels[6] & 0x07FF) >> 6 | (channels[7] & 0x07FF) << 5);
    packet[13] = (uint8_t)((channels[7] & 0x07FF) >> 3);
    packet[14] = (uint8_t)((channels[8] & 0x07FF));
    packet[15] = (uint8_t)((channels[8] & 0x07FF) >> 8 | (channels[9] & 0x07FF) << 3);
    packet[16] = (uint8_t)((channels[9] & 0x07FF) >> 5 | (channels[10] & 0x07FF) << 6);
    packet[17] = (uint8_t)((channels[10] & 0x07FF) >> 2);
    packet[18] = (uint8_t)((channels[10] & 0x07FF) >> 10 | (channels[11] & 0x07FF) << 1);
    packet[19] = (uint8_t)((channels[11] & 0x07FF) >> 7 | (channels[12] & 0x07FF) << 4);
    packet[20] = (uint8_t)((channels[12] & 0x07FF) >> 4 | (channels[13] & 0x07FF) << 7);
    packet[21] = (uint8_t)((channels[13] & 0x07FF) >> 1);
    packet[22] = (uint8_t)((channels[13] & 0x07FF) >> 9 | (channels[14] & 0x07FF) << 2);
    packet[23] = (uint8_t)((channels[14] & 0x07FF) >> 6 | (channels[15] & 0x07FF) << 5);
    packet[24] = (uint8_t)((channels[15] & 0x07FF) >> 3);

    packet[25] = crc8(&packet[2], packet[1] - 1); // CRC

    send_packets(packet, len + 2, 0);   //Len + 2
    //Serial.println("📤 RC Channels Packed sent");
}

void CRSF::send_ping() {

    uint8_t len = 4;
    uint8_t packet[64];
    packet[0] = CRSF_SYNC_byte;   // sync
    packet[1] = len;    // len
    packet[2] = CRSF_FRAMETYPE_DEVICE_PING;   // type
    packet[3] = CRSF_ADDRESS_BROADCAST; 
    packet[4] = CRSF_ADDRESS_RADIO_TRANSMITTER;
    
    // Frame CRC8 (Polynom 0xD5) über [type ... Command_CRC8]
    packet[packet[1]+1] = crc8(&packet[2], packet[1] - 1);

    send_packets(packet, len + 2 , 0);

    //Serial.println("📤 Ping sent");
}
 

void CRSF::send_device_info(const char* name, uint8_t parameter, uint8_t paramVersion) {

    deviceInfoReplyPending = false;

    uint8_t len_name = strlen(name) + 1; // len + null terminator

    uint8_t len = 14 + len_name + 4; // + 4 = "ELRS" for ExpressLRS
    uint8_t packet[64];
    packet[0] = CRSF_SYNC_byte;   // sync
    packet[1] = len;    // len
    packet[2] = CRSF_FRAMETYPE_DEVICE_INFO;   // type
    packet[3] = pingSource;                    // Antwort an PING-Absender
    packet[4] = deviceAddress;

    strcpy((char*)&packet[5], name); // Name
    strcpy((char*)&packet[5 + len_name],"ELRS"); //always "ELRS" for ExpressLRS

    packet[5 + len_name + 4] = 0x00; // hardware version 1
    packet[6 + len_name + 4] = 0x00; // hardware version 2
    packet[7 + len_name + 4] = 0x00; // hardware version 3
    packet[8 + len_name + 4] = 0x00; // hardware version 4

    packet[9 + len_name + 4] = 0x00; // software version 1
    packet[10 + len_name + 4] = 0x00; // software version 2
    packet[11 + len_name + 4] = 0x00; // software version 3
    packet[12 + len_name + 4] = 0x00; // software version 4

    packet[13 + len_name + 4] = parameter; // number of config parameters
    // NEU v7.18: war fest 0x00 - Konfiguratoren wie TBS Agent nutzen genau
    // dieses Byte, um eine bereits gecachte Parameterliste als veraltet zu
    // erkennen und komplett neu einzulesen. Blieb es konstant, zeigte TBS
    // Agent nach einem Firmware-Update (hier: neue WLAN-Felder 174-181)
    // weiterhin seine alte, zwischengespeicherte Menuestruktur - obwohl der
    // Geraete-Zaehler ("number of config parameters" oben) korrekt
    // mitgewachsen war. EdgeTX-Lua-Skripte waren nicht betroffen, da sie ihr
    // Menue bei jedem Lauf frisch aus den Live-Antworten aufbauen und nichts
    // dauerhaft cachen (Feldbefund). Der Aufrufer (ESP32-RC-Sound.ino)
    // uebergibt hier die Firmware-Version, die ohnehin bei jeder Aenderung
    // diszipliniert hochgezaehlt wird - damit aendert sich dieses Byte
    // automatisch bei jedem Firmware-Update, nicht nur wenn jemand daran
    // denkt, es manuell zu pflegen.
    packet[14 + len_name + 4] = paramVersion; // parameter protocol version

    packet[packet[1]+1] = crc8(&packet[2], packet[1] - 1);

    send_packets(packet, len + 2, 0);   //Len + 2

#if DEBUG_CRSF_SEND
    Serial.println("📤 Device Info sent");
#endif    
}

void CRSF::send_param_response_CRSF_UINT8(uint8_t param_id, uint8_t parent, const char* name, uint8_t val, uint8_t min, uint8_t max, const char* unit) { 

    deviceReadReplyPending = false;

    uint8_t len_name = strlen(name) + 1; // len + null terminator
    uint8_t len_unit = strlen(unit) + 1; // len + null terminator

    uint8_t len = 12 + len_name + len_unit; // +1 fuer default Byte
    uint8_t packet[64];
    packet[0] = CRSF_SYNC_byte;   // sync
    packet[1] = len;    // len
    packet[2] = CRSF_FRAMETYPE_PARAMETER_SETTINGS_ENTRY;   // type
    packet[3] = paramReadSource;                  // Antwort an Anfragesteller
    packet[4] = deviceAddress;  // Wir als Geraet
    packet[5] = param_id; //config field index, parameter field 03
    packet[6] = 0x00; // chunks remaining, 0 chunks remaining after this one
    
    packet[7] = parent; // Parent folder
    packet[8] = CRSF_UINT8 | takeParamHiddenFlag(); // Data type (+ Bit 7 versteckt)

    strcpy((char*)&packet[9], name); // Name

    packet[9 + len_name]  = val;     // Value
    packet[10 + len_name] = min;     // min
    packet[11 + len_name] = max;     // max
    packet[12 + len_name] = val;     // default (= aktueller Wert)

    strcpy((char*)&packet[13 + len_name], unit); // unit string
    
    packet[packet[1]+1] = crc8(&packet[2], packet[1] - 1);

    send_packets(packet, len + 2, 0);

#if DEBUG_CRSF_SEND    
    Serial.print("📤 Device Parameter UINT8 sent ID: "); 
    Serial.print(param_id);
    Serial.print(" parent: ");
    Serial.print(parent);
    Serial.print(" Val: ");
    Serial.println(val);
#endif    
}

void CRSF::send_param_response_CRSF_FLOAT(uint8_t param_id, uint8_t parent, const char* name, uint32_t val, uint32_t min, uint32_t max, uint32_t default_val, uint8_t decimal_point, uint32_t step_size, const char* unit) {

    deviceReadReplyPending = false;

    uint8_t len_name = strlen(name) + 1; // len + null terminator
    uint8_t len_unit = strlen(unit) + 1; // len + null terminator

    uint8_t len = 29 + len_name + len_unit;
    uint8_t packet[64];
    packet[0] = CRSF_SYNC_byte;   // sync
    packet[1] = len;    // len
    packet[2] = CRSF_FRAMETYPE_PARAMETER_SETTINGS_ENTRY;   // type
    packet[3] = paramReadSource;                  // Antwort an Anfragesteller
    packet[4] = deviceAddress;  // Wir als Geraet
    packet[5] = param_id; //config field index, parameter field 03
    packet[6] = 0x00; // chunks remaining, 0 chunks remaining after this one
    
    packet[7] = parent; // Parent folder
    packet[8] = CRSF_FLOAT; // Data type

    strcpy((char*)&packet[9], name); // Name

    packet[9  + len_name] = ((val >> 24) & 0xFF);   // Value 4
	packet[10 + len_name] = ((val >> 16) & 0xFF);   // Value 3
	packet[11 + len_name] = ((val >> 8) & 0xFF);    // Value 2
    packet[12 + len_name] = (val & 0xFF);           // Value 1

    packet[13 + len_name] = ((min >> 24) & 0xFF);   // min Value 4
    packet[14 + len_name] = ((min >> 16) & 0xFF);   // min Value 3
    packet[15 + len_name] = ((min >> 8) & 0xFF);    // min Value 2	
    packet[16 + len_name] = (min & 0xFF);           // min Value 1

    packet[17 + len_name] = ((max >> 24) & 0xFF);   // max Value 4
    packet[18 + len_name] = ((max >> 16) & 0xFF);   // max Value 3
    packet[19 + len_name] = ((max >> 8) & 0xFF);    // max Value 2	
    packet[20 + len_name] = (max & 0xFF);           // max Value 1

    packet[21 + len_name] = ((default_val >> 24) & 0xFF);   // default Value 4
    packet[22 + len_name] = ((default_val >> 16) & 0xFF);   // default Value 3
    packet[23 + len_name] = ((default_val >> 8) & 0xFF);    // default Value 2 	
    packet[24 + len_name] = (default_val & 0xFF);           // default Value 1  

    packet[25 + len_name] = decimal_point;   // Decimal_point

    packet[26 + len_name] = ((step_size >> 24) & 0xFF);   // Step Size Value 4 
	packet[27 + len_name] = ((step_size >> 16) & 0xFF);   // Step Size Value 3
	packet[28 + len_name] = ((step_size >> 8) & 0xFF);    // Step Size Value 2
    packet[29 + len_name] = (step_size & 0xFF);           // Step Size Value 1

    strcpy((char*)&packet[30 + len_name], unit); // Name
    
    packet[packet[1]+1] = crc8(&packet[2], packet[1] - 1);

    send_packets(packet, len + 2, 0);

#if DEBUG_CRSF_SEND
    Serial.print("📤 Device Parameter FLOAT sent ID: "); 
    Serial.print(param_id);
    Serial.print(" parent: ");
    Serial.print(parent);
    Serial.print(" Val: ");
    Serial.println(val);
#endif    
}
/*
void CRSF::send_param_response_CRSF_TEXT_SELECTION(uint8_t param_id, uint8_t parent, const char* name, const char* options, uint8_t val, uint8_t min, uint8_t max) {

    deviceReadReplyPending = false;

    uint8_t len_name = strlen(name) + 1; // len + null terminator
    uint8_t len_options = strlen(options) + 1; // len + null terminator

    uint8_t len = 13 + len_name + len_options;
    uint8_t packet[64];
    packet[0] = CRSF_SYNC_byte;   // sync
    packet[1] = len;    // len
    packet[2] = CRSF_FRAMETYPE_PARAMETER_SETTINGS_ENTRY;   // type
    packet[3] = paramReadSource;                  // Antwort an Anfragesteller
    packet[4] = deviceAddress;  // Wir als Geraet
    packet[5] = param_id; //crfs_buffer[5]; //config field index, parameter field 03
    packet[6] = 0x00; // chunks remaining, 0 chunks remaining after this one
    
    packet[7] = parent; // Parent folder
    packet[8] = CRSF_TEXT_SELECTION; // Data type

    strcpy((char*)&packet[9], name); // Name
    strcpy((char*)&packet[9 + len_name],options); //Option

    packet[9 + len_name + len_options] = val; // Value
    packet[10 + len_name + len_options] = min; // min
    packet[11 + len_name + len_options] = max; // max
    packet[12 + len_name + len_options] = 0x00; // default
    packet[13 + len_name + len_options] = 0x00; // units (null-terminated string)
    
    packet[packet[1]+1] = crc8(&packet[2], packet[1] - 1);

    send_packets(packet, len + 2, 0);

#if DEBUG_CRSF_SEND
    Serial.print("📤 Device Parameter TEXT_SELECTION sent ID: ");
    Serial.print(param_id);
    Serial.print(" parent: ");
    Serial.print(parent);
    Serial.print(" Val: ");
    Serial.println(val);
#endif    
}
*/
void CRSF::send_param_response_CRSF_TEXT_SELECTION(
    uint8_t param_id,
    uint8_t parent,
    const char* name,
    const char* options,
    uint8_t val,
    uint8_t min,
    uint8_t max)
{
    deviceReadReplyPending = false;

    // ----------------------------------------------------
    // 1. Payload vorbereiten (beliebige Länge möglich)
    // ----------------------------------------------------
    uint8_t payload[256];
    uint16_t p = 0;

    payload[p++] = parent;
    payload[p++] = CRSF_TEXT_SELECTION | takeParamHiddenFlag();   // + Bit 7 versteckt

    // Name
    strcpy((char*)&payload[p], name);
    p += strlen(name) + 1;

    // Options
    strcpy((char*)&payload[p], options);
    p += strlen(options) + 1;

    // Werte
    payload[p++] = val;
    payload[p++] = min;
    payload[p++] = max;
    payload[p++] = 0x00; // default
    payload[p++] = 0x00; // units (null string)

    // ----------------------------------------------------
    // 2. Chunk-Berechnung
    // ----------------------------------------------------
    // Serial.print("Anzahl zu übertragen : ");
    // Serial.print(p);
    const uint8_t MAX_CHUNK = 55; // 64 - Header - CRC -1
    uint8_t total_chunks = (p + MAX_CHUNK - 1) / MAX_CHUNK;

    uint16_t offset = 0;

    // Serial.print(" Anzahl zu chunks : ");
    // Serial.print(total_chunks);

    // ----------------------------------------------------
    // 3. Nur den angefragten Chunk senden (seit 1.2.1)
    // ----------------------------------------------------
    // Vorher gingen alle Chunks auf einmal raus und die Chunk-Nummer der
    // Anfrage wurde ignoriert. Das ELRS-Lua fragt Chunk 1, 2 ... einzeln an
    // und bekam jedes Mal wieder Chunk 0 - Eintraege ueber 55 Byte (z. B.
    // "Port B Baudrate") wurden nie fertig geladen, der ganze Ordner fehlte.
    uint8_t want = paramReadChunk < total_chunks ? paramReadChunk : 0;
    paramReadChunk = 0;
    offset = (uint16_t)want * MAX_CHUNK;
    for (uint8_t chunk = want; chunk <= want; chunk++)
    {
        uint8_t remaining = total_chunks - chunk - 1;
        uint8_t size = ((uint16_t)(p - offset) > MAX_CHUNK)
               ? MAX_CHUNK
               : (p - offset);

    // Serial.print(" remaining  : ");
    // Serial.print(remaining );

        // Laenge = Typ, Ziel, Absender, ID, Rest-Chunks (5) + Nutzdaten + CRC.
        // Bis 1.2.0 stand hier 7 + size: ein ungenutztes Byte vor der CRC,
        // das beim Zusammensetzen mehrerer Chunks mitten in die Optionen geriet.
        uint8_t len = 6 + size;
        uint8_t packet[64];

        packet[0] = CRSF_SYNC_byte;
        packet[1] = len;
        packet[2] = CRSF_FRAMETYPE_PARAMETER_SETTINGS_ENTRY;
        packet[3] = paramReadSource;                  // Antwort an Anfragesteller
        packet[4] = deviceAddress;
        packet[5] = param_id;
        packet[6] = remaining;

        memcpy(&packet[7], &payload[offset], size);

        // CRC
        packet[len + 1] = crc8(&packet[2], len - 1);

        // Senden
        send_packets(packet, len + 2, 0);

        // delay entfernt - blockiert RC-Loop

        offset += size;
    }
}


void CRSF::send_param_response_CRSF_STRING(uint8_t param_id, uint8_t parent, const char* name, const char* value, uint8_t val, uint8_t max_length) {

    deviceReadReplyPending = false;

    uint8_t len_name = strlen(name) + 1; // len + null terminator
    uint8_t len_value = strlen(value) + 1; // len + null terminator

    uint8_t len = 9 + len_name + len_value;
    uint8_t packet[64];
    packet[0] = CRSF_SYNC_byte;   // sync
    packet[1] = len;    // len
    packet[2] = CRSF_FRAMETYPE_PARAMETER_SETTINGS_ENTRY;   // type
    packet[3] = paramReadSource;                  // Antwort an Anfragesteller
    packet[4] = deviceAddress;  // Wir als Geraet
    packet[5] = param_id; //config field index, parameter field 03
    packet[6] = 0x00; // chunks remaining, 0 chunks remaining after this one
    
    packet[7] = parent; // Parent folder
    packet[8] = CRSF_STRING; // Data type

    strcpy((char*)&packet[9], name); // Name
    strcpy((char*)&packet[9 + len_name],value); //Option

    packet[9 + len_name + len_value] = 0x00; // String_max_length
    
    packet[packet[1]+1] = crc8(&packet[2], packet[1] - 1);

    send_packets(packet, len + 2, 0);

#if DEBUG_CRSF_SEND
    Serial.println("📤 Device Parameter STRING sent");
#endif    
}

void CRSF::send_param_response_CRSF_FOLDER(uint8_t param_id, uint8_t parent, const char* name, std::initializer_list<uint8_t> children) {
    uint8_t buf[CRSF_PACKET_SIZE];
    uint8_t n = 0;
    for (uint8_t c : children) { if (n < sizeof(buf)) buf[n++] = c; }
    send_param_response_CRSF_FOLDER(param_id, parent, name, buf, n);
}

void CRSF::send_param_response_CRSF_FOLDER(uint8_t param_id, uint8_t parent, const char* name, const uint8_t* children, uint8_t count) {

    deviceReadReplyPending = false;

    uint8_t len_name = strlen(name) + 1; // len + null terminator
    uint8_t len_children = count;

    // Typ, Ziel, Quelle, Nr, Chunks, Parent, Datentyp (7) + Name + Kinder
    // + 0xFF-Terminator + CRC. Vor v1.0.0 war len um 1 zu gross, dadurch
    // ging ein uninitialisiertes Byte mit auf den Bus.
    uint8_t len = 9 + len_name + len_children;
    uint8_t packet[64];
    packet[0] = CRSF_SYNC_byte;   // sync
    packet[1] = len;    // len
    packet[2] = CRSF_FRAMETYPE_PARAMETER_SETTINGS_ENTRY;   // type
    packet[3] = paramReadSource;                  // Antwort an Anfragesteller
    packet[4] = deviceAddress;  // Wir als Geraet
    packet[5] = param_id; //config field index, parameter field 03
    packet[6] = 0x00; // chunks remaining, 0 chunks remaining after this one
    
    packet[7] = parent; // Parent folder
    packet[8] = CRSF_FOLDER | takeParamHiddenFlag(); // Data type (+ Bit 7 versteckt)

    strcpy((char*)&packet[9], name); // Name

    // List_of_children
    int packet_count = 9;
    for (uint8_t i = 0; i < count; i++) {
        packet[packet_count + len_name] = children[i];
        packet_count ++;
    }
    
    //packet[packet_count + len_name] = 0xFF;        // children Liste mit 0xFF abschließen
    packet[9 + len_name + len_children] = 0xFF;        // children Liste mit 0xFF abschliessen

    packet[packet[1]+1] = crc8(&packet[2], packet[1] - 1);

    send_packets(packet, len + 2, 0);

#if DEBUG_CRSF_SEND
    Serial.println("📤 Device Parameter FOLDER sent");
#endif    
}

void CRSF::send_param_response_CRSF_INFO(uint8_t param_id, uint8_t parent, const char* name, const char* info) {

    deviceReadReplyPending = false;

    uint8_t len_name = strlen(name) + 1; // len + null terminator
    uint8_t len_info = strlen(info) + 1; // len + null terminator

    uint8_t len = 8 + len_name + len_info;
    uint8_t packet[64];
    packet[0] = CRSF_SYNC_byte;   // sync
    packet[1] = len;    // len
    packet[2] = CRSF_FRAMETYPE_PARAMETER_SETTINGS_ENTRY;   // type
    packet[3] = paramReadSource;                  // Antwort an Anfragesteller
    packet[4] = deviceAddress;  // Wir als Geraet
    packet[5] = param_id; //config field index, parameter field 03
    packet[6] = 0x00; // chunks remaining, 0 chunks remaining after this one
    
    packet[7] = parent; // Parent folder
    packet[8] = CRSF_INFO | takeParamHiddenFlag(); // Data type (+ Bit 7 versteckt)

    strcpy((char*)&packet[9], name); // Name
    strcpy((char*)&packet[9 + len_name], info); // Info
    
    packet[packet[1]+1] = crc8(&packet[2], packet[1] - 1);

    send_packets(packet, len + 2 , 0);

#if DEBUG_CRSF_SEND
    Serial.print("📤 Device Parameter INFO sent ID: ");
    Serial.print(param_id);
    Serial.print(" parent: ");
    Serial.println(parent);
#endif    
}

void CRSF::send_command_MWSET(uint8_t adress, uint8_t state) {

    uint8_t len = 9;
    uint8_t packet[64];
    packet[0] = CRSF_SYNC_byte;   // sync
    packet[1] = len;    // len
    packet[2] = CRSF_FRAMETYPE_COMMAND;   // type
    packet[3] = CRSF_ADDRESS_FLIGHT_CONTROLLER; 
    packet[4] = CRSF_ADDRESS_RADIO_TRANSMITTER;
    packet[5] = 0xa1; // Commands for MultiSwitch (realm 0xa1)
    packet[6] = 0x01; // set 8 binary-switches

    packet[7] = adress; // switch-address (0 … 255)
    packet[8] = state;  // state of 8 binary switches
    
    // Command_CRC8 (Polynom 0xBA) über [Frame Type (0x32)] + [Destination] + [Origin] + [Command ID] + [Payload]
    packet[9] = crc8_ba(&packet[2], len - 2);
    
    // Frame CRC8 (Polynom 0xD5) über [type ... Command_CRC8]
    packet[packet[1]+1] = crc8(&packet[2], packet[1] - 1);

    send_packets(packet, len + 2 , 0);
    Serial.println("📤 Command MWSET sent");
}

void CRSF::send_command_MWSET4(uint8_t adress, uint8_t stateH, uint8_t stateL) {

    uint8_t len = 10;
    uint8_t packet[64];
    packet[0] = CRSF_SYNC_byte;   // sync
    packet[1] = len;    // len
    packet[2] = CRSF_FRAMETYPE_COMMAND;   // type
    packet[3] = CRSF_ADDRESS_FLIGHT_CONTROLLER; 
    packet[4] = CRSF_ADDRESS_RADIO_TRANSMITTER;
    packet[5] = 0xa1; // Commands for MultiSwitch (realm 0xa1)
    packet[6] = 0x07; // set 8 4-state switches (2-bits for each switch → 2 bytes payload)

    packet[7] = adress; // switch-address (0 … 255)
    packet[8] = stateH; // state of 4 2-ary switches
    packet[9] = stateL; // state of 4 2-ary switches 

    // Command_CRC8 (Polynom 0xBA) über [Frame Type (0x32)] + [Destination] + [Origin] + [Command ID] + [Payload]
    packet[10] = crc8_ba(&packet[2], len - 2);
    
    // Frame CRC8 (Polynom 0xD5) über [type ... Command_CRC8]
    packet[packet[1]+1] = crc8(&packet[2], packet[1] - 1);

    send_packets(packet, len + 2 , 0);

    //Serial.println("📤 Command MWSET4 sent");
    //Serial.println(adress);
    //Serial.println(stateH);
    //Serial.println(stateL);
    //Serial.println("---");
}

void CRSF::send_command_MWSET4M(uint8_t adress_1, uint8_t stateH_1, uint8_t stateL_1, uint8_t adress_2, uint8_t stateH_2, uint8_t stateL_2) {

    uint8_t len = 14;
    uint8_t packet[64];
    packet[0] = CRSF_SYNC_byte;   // sync
    packet[1] = len;    // len
    packet[2] = CRSF_FRAMETYPE_COMMAND;   // type
    packet[3] = CRSF_ADDRESS_FLIGHT_CONTROLLER; 
    packet[4] = CRSF_ADDRESS_RADIO_TRANSMITTER;
    packet[5] = 0xa1; // Commands for MultiSwitch (realm 0xa1)
    packet[6] = 0x09; // set 8 4-state switches (2-bits for each switch → 2 bytes payload)

    packet[7] = 2; // number of following 3-byte sequences
    packet[8] = adress_2; // switch-address (0 … 255)
    packet[9] = stateH_2; // state of 4 2-ary switches
    packet[10] = stateL_2; // state of 4 2-ary switches
    packet[11] = adress_1; // switch-address (0 … 255)
    packet[12] = stateH_1; // state of 4 2-ary switches
    packet[13] = stateL_1; // state of 4 2-ary switches    

    // Command_CRC8 (Polynom 0xBA) über [Frame Type (0x32)] + [Destination] + [Origin] + [Command ID] + [Payload]
    packet[14] = crc8_ba(&packet[2], len - 2);
    
    // Frame CRC8 (Polynom 0xD5) über [type ... Command_CRC8]
    packet[packet[1]+1] = crc8(&packet[2], packet[1] - 1);

    send_packets(packet, len + 2 , 0);

    //Serial.println("📤 Command MWSET4M sent");
    //Serial.println(adress_1);
    //Serial.println(stateH_1);
    //Serial.println(stateL_1);
    //Serial.println("---");
    //Serial.println(adress_2);
    //Serial.println(stateH_2);
    //Serial.println(stateL_2);
}

void CRSF::send_command_MWPROP(uint8_t adress, uint8_t channel, uint8_t duty ) {

    uint8_t len = 10; // inkl. Command_CRC8 (fehlte vor v1.0.0)
    uint8_t packet[64];
    packet[0] = CRSF_SYNC_byte;   // sync
    packet[1] = len;    // len
    packet[2] = CRSF_FRAMETYPE_COMMAND;   // type
    packet[3] = CRSF_ADDRESS_FLIGHT_CONTROLLER; 
    packet[4] = CRSF_ADDRESS_RADIO_TRANSMITTER;
    packet[5] = 0xa1; // Commands for MultiSwitch (realm 0xa1)
    packet[6] = 0x02; // set a proportional value (8-bit resolution)

    packet[7] = adress;  // switch-address (0 … 255)
    packet[8] = channel; // number of the output channel
    packet[9] = duty;    // duty for the output channel

    // Command_CRC8 (Polynom 0xBA) über [Frame Type (0x32)] + [Destination] + [Origin] + [Command ID] + [Payload]
    packet[10] = crc8_ba(&packet[2], len - 2);

    // Frame CRC8 (Polynom 0xD5) über [type ... Command_CRC8]
    packet[packet[1]+1] = crc8(&packet[2], packet[1] - 1);

    send_packets(packet, len + 2 , 0);
    //Serial.println("📤 Command MWPROP sent");
    //Serial.println(adress);
    //Serial.println(channel);
    //Serial.println(duty);
}

void CRSF::send_param(uint8_t parameter_number, uint8_t data) {

    uint8_t len = 6;
    uint8_t packet[64];
    packet[0] = CRSF_ADDRESS_CRSF_TRANSMITTER;   // sync ? OpenTX/EdgeTX sends the channels packet starting with 0xEE instead of 0xC8
    packet[1] = len;    // len
    packet[2] = CRSF_FRAMETYPE_PARAMETER_WRITE;
    packet[3] = CRSF_ADDRESS_CRSF_TRANSMITTER;
    packet[4] = CRSF_ADDRESS_RADIO_TRANSMITTER;
    packet[5] = parameter_number;
    packet[6] = data;
    packet[packet[1]+1] = crc8(&packet[2], packet[1] - 1);

    send_packets(packet, len + 2 , 0);

#if DEBUG_CRSF_SEND
    Serial.println("📤 Paramenter sent");
#endif     
}

void CRSF::read_param(uint8_t parameter_number, uint8_t parameter_chunk_number){

    uint8_t len = 6;
    uint8_t packet[64];
    packet[0] = CRSF_ADDRESS_CRSF_TRANSMITTER;   // sync ? OpenTX/EdgeTX sends the channels packet starting with 0xEE instead of 0xC8
    packet[1] = len;    // len
    packet[2] = CRSF_FRAMETYPE_PARAMETER_READ;
    packet[3] = CRSF_ADDRESS_CRSF_TRANSMITTER;
    packet[4] = CRSF_ADDRESS_RADIO_TRANSMITTER;
    packet[5] = parameter_number;
    packet[6] = parameter_chunk_number;
    packet[packet[1]+1] = crc8(&packet[2], packet[1] - 1);

    send_packets(packet, len + 2 , 0);

#if DEBUG_CRSF_SEND
    Serial.println("📤 Paramenter read");
#endif     
}

//******************Telemetry

void CRSF::send_tele_GPS(int32_t latitude, int32_t longitude, uint16_t groundspeed, uint16_t heading, uint16_t altitude, uint8_t satellites) {

    uint8_t len = 17;
    uint8_t packet[64];
    packet[0] = CRSF_SYNC_byte;   // sync
    packet[1] = len;    // len
    packet[2] = CRSF_FRAMETYPE_GPS;   // type
    packet[3] = ((latitude >> 24) & 0xFF);            // latitude     big endian
    packet[4] = ((latitude >> 16) & 0xFF);            // latitude     big endian
    packet[5] = ((latitude >> 8) & 0xFF);             // latitude     big endian 
    packet[6] = (latitude & 0xFF);                    // latitude     big endian

    packet[7] = ((longitude >> 24) & 0xFF);           // longitude     big endian
    packet[8] = ((longitude >> 16) & 0xFF);           // longitude     big endian
    packet[9] = ((longitude >> 8) & 0xFF);            // longitude     big endian 
    packet[10] = (longitude & 0xFF);                  // longitude     big endian

    packet[11] = ((groundspeed >> 8) & 0xFF);         // groundspeed   big endian 
    packet[12] = (groundspeed & 0xFF);                // groundspeed   big endian

    packet[13] = ((heading >> 8) & 0xFF);             // heading   big endian 
    packet[14] = (heading & 0xFF);                    // heading   big endian

    packet[15] = (((altitude + 1000) >> 8) & 0xFF);     // altitude + 1000 offset  big endian 
    packet[16] = ((altitude + 1000) & 0xFF);            // altitude + 1000 offset  big endian    

    packet[17] = satellites;                          // satellites 0-100%

    packet[packet[1]+1] = crc8(&packet[2], packet[1] - 1);

    send_packets(packet, len + 2 , 0);
    
#if DEBUG_CRSF_TELE    
    Serial.println("📤 Command send_tele_GPS");
#endif    
}

void CRSF::send_tele_Battery_Sensor(uint16_t voltage, uint16_t current, uint32_t capacity_used, uint8_t remaining) {

    uint8_t len = 10;
    uint8_t packet[64];
    packet[0] = CRSF_SYNC_byte;   // sync
    packet[1] = len;    // len
    packet[2] = CRSF_FRAMETYPE_BATTERY_SENSOR;   // type
    packet[3] = ((voltage >> 8) & 0xFF);            // voltage 2   V * 10 big endian 
    packet[4] = (voltage & 0xFF);                   // voltage 1   V * 10 big endian
    packet[5] = ((current >> 8) & 0xFF);            // current 2   A * 10 big endian
    packet[6] = (current & 0xFF);                   // current 1   A * 10 big endian
    packet[7] = ((capacity_used >> 16) & 0xFF);     // capacity_used 3 mah big endian
    packet[8] = ((capacity_used >> 8) & 0xFF);      // capacity_used 2 mah big endian    
    packet[9] = (capacity_used & 0xFF);             // capacity_used 1 mah big endian
    packet[10] = remaining;                         // remaining 0-100%

    packet[packet[1]+1] = crc8(&packet[2], packet[1] - 1);

    send_packets(packet, len + 2 , 0);
    
#if DEBUG_CRSF_TELE    
    Serial.println("📤 Command send_tele_Battery_Sensor");
#endif     
}

void CRSF::send_tele_Vario(uint16_t v_speed) {

    uint8_t len = 4;
    uint8_t packet[64];
    packet[0] = CRSF_SYNC_byte;   // sync
    packet[1] = len;    // len
    packet[2] = CRSF_FRAMETYPE_VARIO;   // type
    packet[3] = ((v_speed >> 8) & 0xFF);            // v_speed   V * 10 big endian 
    packet[4] = (v_speed & 0xFF);                   // v_speed   V * 10 big endian

    packet[packet[1]+1] = crc8(&packet[2], packet[1] - 1);

    send_packets(packet, len + 2 , 0);

#if DEBUG_CRSF_TELE
    Serial.println("📤 Command send_tele_Vario");
#endif     
}

void CRSF::send_tele_Baro_Altitude(int32_t altitude_dm, int16_t vertical_speed_cm_s) {

    uint16_t altitude_packed = get_altitude_packed(altitude_dm);
    uint8_t vertical_speed_packed = get_vertical_speed_packed(vertical_speed_cm_s);

    uint8_t len = 5;
    uint8_t packet[64];
    packet[0] = CRSF_SYNC_byte;   // sync
    packet[1] = len;    // len
    packet[2] = CRSF_FRAMETYPE_BARO_ALTITUDE;   // type
    packet[3] = ((altitude_packed >> 8) & 0xFF);            // altitude_packed   V * 10 big endian 
    packet[4] = (altitude_packed & 0xFF);                   // altitude_packed   V * 10 big endian
    packet[5] = vertical_speed_packed;                      // vertical_speed_packed in cm_s

    packet[packet[1]+1] = crc8(&packet[2], packet[1] - 1);

    send_packets(packet, len + 2 , 0);

#if DEBUG_CRSF_TELE
    Serial.println("📤 Command send_tele_Baro_Altitude");
#endif     
}

void CRSF::send_tele_Airspeed(uint16_t speed) {

    uint8_t len = 4;
    uint8_t packet[64];
    packet[0] = CRSF_SYNC_byte;   // sync
    packet[1] = len;    // len
    packet[2] = CRSF_FRAMETYPE_AIRSPEED;   // type
    packet[3] = ((speed >> 8) & 0xFF);            // speed   V * 10 big endian 
    packet[4] = (speed & 0xFF);                   // speed   V * 10 big endian

    packet[packet[1]+1] = crc8(&packet[2], packet[1] - 1);

    send_packets(packet, len + 2 , 0);

#if DEBUG_CRSF_TELE    
    Serial.println("📤 Command send_tele_Airspeed");
#endif    
}

void CRSF::send_tele_RPM(uint8_t rpm_source_id, std::initializer_list<int32_t> rpm_values) {

    uint8_t count = rpm_values.size();
    if (count == 0 || count > 19) return;   // CRSF Limit

    // Länge: 1 Byte source_id + 3 Bytes pro RPM-Wert
    uint8_t len = 3 + (count * 3);

    uint8_t packet[64];
    packet[0] = CRSF_SYNC_byte;                 // Sync
    packet[1] = len;                            // Length
    packet[2] = CRSF_FRAMETYPE_RPM;             // Frame type
    packet[3] = rpm_source_id;                  // Source ID

    // RPM-Werte packen (24-bit signed, big endian)
    uint8_t pos = 4;
    for (int32_t rpm : rpm_values) {
        packet[pos++] = (rpm >> 16) & 0xFF;
        packet[pos++] = (rpm >> 8)  & 0xFF;
        packet[pos++] = rpm & 0xFF;
    }

    // CRC
    packet[packet[1] + 1] = crc8(&packet[2], packet[1] - 1);

    // Senden
    send_packets(packet, len + 2, 0);

#if DEBUG_CRSF_TELE
    Serial.println("📤 Telemetry RPM sent");
#endif
}

void CRSF::send_tele_Temp(uint8_t temp_source_id, std::initializer_list<int32_t> temperature)
{

    uint8_t count = temperature.size();
    if (count == 0 || count > 19) return;   // CRSF Limit

    uint8_t len = 3 + (count * 2);          // source_id + 2 bytes per temp

    uint8_t packet[64];
    packet[0] = CRSF_SYNC_byte;             // Sync
    packet[1] = len;                        // Length
    packet[2] = CRSF_FRAMETYPE_TEMP;        // Frame type
    packet[3] = temp_source_id;             // Source ID

    uint8_t pos = 4;

    // Temperaturwerte packen (16-bit signed, big endian)
    for (int32_t t : temperature)
    {
        int16_t temp = (int16_t)t;
        packet[pos++] = (temp >> 8) & 0xFF;
        packet[pos++] = temp & 0xFF;
    }

    // CRC
    packet[packet[1] + 1] = crc8(&packet[2], packet[1] - 1);

    send_packets(packet, len + 2, 0);

#if DEBUG_CRSF_TELE
    Serial.println("📤 Telemetry TEMP sent");
#endif
}

void CRSF::send_tele_Voltages(uint8_t Voltage_source_id, std::initializer_list<int32_t> voltage_values)
{

    uint8_t count = voltage_values.size();
    if (count == 0 || count > 19) return;   // CRSF Limit

    uint8_t len = 3 + (count * 2);          // origin + 2 bytes per voltage

    uint8_t packet[64];
    packet[0] = CRSF_SYNC_byte;             // Sync
    packet[1] = len;                        // Length
    packet[2] = CRSF_FRAMETYPE_VOLTAGES;     // Frame type
    packet[3] = Voltage_source_id;             // Source / origin

    uint8_t pos = 4;

    // Spannungswerte packen (16-bit unsigned, big endian)
    for (int32_t v : voltage_values)
    {
        uint16_t volt = (uint16_t)v;
        packet[pos++] = (volt >> 8) & 0xFF;
        packet[pos++] = volt & 0xFF;
    }

    // CRC
    packet[packet[1] + 1] = crc8(&packet[2], packet[1] - 1);

    send_packets(packet, len + 2, 0);

#if DEBUG_CRSF_TELE
    Serial.println("📤 Telemetry VOLTAGES sent");
#endif
}

void CRSF::send_tele_Attitude(int16_t pitch, int16_t roll, int16_t yaw) {

    uint8_t len = 8;
    uint8_t packet[64];
    packet[0] = CRSF_SYNC_byte;   // sync
    packet[1] = len;    // len
    packet[2] = CRSF_FRAMETYPE_ATTITUDE;   // type
    packet[3] = ((pitch >> 8) & 0xFF);            // pitch   big endian 
    packet[4] = (pitch & 0xFF);                   // pitch   big endian
    packet[5] = ((roll >> 8) & 0xFF);             // roll   big endian 
    packet[6] = (roll & 0xFF);                    // roll   big endian
    packet[7] = ((yaw >> 8) & 0xFF);              // yaw   big endian 
    packet[8] = (yaw & 0xFF);                     // yaw   big endian    

    packet[packet[1]+1] = crc8(&packet[2], packet[1] - 1);

    send_packets(packet, len + 2 , 0);

#if DEBUG_CRSF_TELE
    Serial.println("📤 Command send_tele_Attitude");
#endif  
}
