mnorden81/RC-Multiswitch-ESP32-S3/firmware/RC_Multiswitch/src/RC_Common/rc_common.h

// rc_common.h - RC_Common, gemeinsame Basis aller ESP32-Firmwaren
// (RC-Multiswitch, Multiswitch Basis, Soundmodul Basis, Soundmodul Mini).
//
// Jedes Projekt traegt eine identische Kopie dieses Ordners (keine externe
// Abhaengigkeit). Aenderungen immer in allen Kopien nachziehen und
// RC_COMMON_VERSION hochzaehlen. MANIFEST.sha256 listet den Inhalt; die CI
// jedes Repos prueft damit, dass die Kopie unveraendert ist.
// Aenderungshistorie: README.md in diesem Ordner.
#ifndef RC_COMMON_H
#define RC_COMMON_H

#define RC_COMMON_VERSION "1.3.0"

#endif
