mnorden81/RC-Multiswitch-ESP32-S3/(commit log)

2026-10-28 v4.07: CRSF als Werkseinstellung, Abnahmepruefung
    - Werkseinstellung RC-System 4 = CRSF statt 0 = FrSky SBUS (neue Module
    und nach Zuruecksetzen; gespeicherte Einstellungen bleiben)
    - Lua-Feld Version aus der Versionsnummer statt fest v4.05
    - docs/Abnahmepruefung.md: Pruefliste fuer fertig gebaute Module,
    Kapitel 8 der Spezifikation verweist darauf
    Claude-Session: https://claude.ai/code/session_0118D4qqHjKHM32ZHnrr94K6
2026-10-29 Gehaeuse fuer RC-Multiswitch-ESP32-S3 (STL, STEP, CadQuery-Quelle, 3D-Vorschau)
    Claude-Session: https://claude.ai/code/session_0118D4qqG9opHfjp2Bh2BN8S
    [Gehaeuse_Deckel.step, Gehaeuse_Deckel.stl, Gehaeuse_Unterteil.step, Gehaeuse_Unterteil.stl]
2026-10-30 Hardware: NEG- und POS-Variante (TBD62783APG), UART-Beschriftung korrigiert
    - Neues KiCad-Projekt RC-Multiswitch-ESP32-S3-NEG: ULN2803A, Platine 1:1 wie Original
    - Neues KiCad-Projekt RC-Multiswitch-ESP32-S3-POS: positiv schaltend mit TBD62783APG
    (U2 Pin 9 = VLOAD, Pin 10 = GND, J1-Schiene auf GND, drei Bahnen an U2, Bestueckungsdruck)
    - Original-Schaltplan v0.4: UART B/C RX/TX-Labels passend zu Platine und Firmware
    - README-hardware: Abschnitt zu den Varianten
    Claude-Session: https://claude.ai/code/session_0118D4qppRkb6gR5m3R2CZyV
    [RC-Multiswitch-ESP32-S3-NEG.kicad_pcb, RC-Multiswitch-ESP32-S3-NEG.kicad_sch, RC-Multiswitch-ESP32-S3.kicad_sch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]
2026-10-30 Hardware: TBD62083APG statt ULN2803A, Original-Projekt entfernt
    ULN2803A ist abgekuendigt. Der TBD62083APG (DMOS) hat dieselbe Pinbelegung und passt in denselben Sockel, Leiterbahnen und Netze bleiben unveraendert. Schaltplan-Symbol, Bauteilwert, Bestueckungsdruck und Doku angepasst.
    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
    [RC-Multiswitch-ESP32-S3-NEG.kicad_pcb, RC-Multiswitch-ESP32-S3-NEG.kicad_sch, RC-Multiswitch-ESP32-S3.kicad_pcb, RC-Multiswitch-ESP32-S3.kicad_sch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]
2026-10-30 Gehaeuse: Version mit gewinkelter Stiftleiste 2x8 fuer J1
    gehaeuse.py --gewinkelt erzeugt Unterteil/Deckel *_gewinkelt: Stecker der
    8 Ausgaenge seitlich durch einen Wandschlitz 21,5 x 6,2 mm, Deckel ueber
    J1 geschlossen. Platine unveraendert. Dazu README-Abschnitt, 3D-Vorschau
    und Bild. Die stehende Version bleibt unveraendert (Volumen geprueft).
    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
    [Gehaeuse_Deckel_gewinkelt.step, Gehaeuse_Deckel_gewinkelt.stl, Gehaeuse_Unterteil_gewinkelt.step, Gehaeuse_Unterteil_gewinkelt.stl]
2026-11-10 Autor: PiperPilot statt vollem Namen (#16)
    Voller Name in Code-Kommentaren und DOCX (Autor-Feld und Text)
    durch PiperPilot ersetzt.
    Claude-Session: https://claude.ai/code/session_0118D4qsuskq7CY6JdgR6nyy
2026-11-14 Lua: PWM Festwert bleibt bei MWprop ein Zahlenfeld
    Bei PWM Modus MWprop wurde 'PWM Festwert' zum Info-Feld. Das ELRS-Lua-
    Skript laedt nach einer Aenderung nur Zahlen- und Auswahlfelder neu, daher
    liess sich der Festwert nach dem Zurueckstellen auf Festwert erst nach
    Verlassen des Menues einstellen. Jetzt bleibt es ein Zahlenfeld und ist
    bei MWprop gesperrt (min = max).
    Claude-Session: https://claude.ai/code/session_0118D4qtmncHargSS3A41WBD
2026-11-14 README: Anleitung zum Flashen
    Schritt-fuer-Schritt-Anleitung fuer Martin (Arduino IDE, fertige Datei
    aus GitHub Actions, Update per WLAN). Nur README, kein Code.
    Claude-Session: https://claude.ai/code/session_0118D4qqum127kn2FfD8dkis
2026-11-14 v4.09: Lua-Menue uebersichtlicher (RC_Common 1.3.0)
    Chunk-Fix fuer lange Auswahlfelder, Werte in Ordnernamen, Felder ohne Wirkung ausgeblendet (wie RC-Multiswitch-Sound v1.05).
    Claude-Session: https://claude.ai/code/session_0118D4qs42NFJUudn7WPSqpv
    [RC_Multiswitch.ino, crsf_esp32.cpp, crsf_esp32.h, lua_menu.cpp, lua_menu.h, rc_common.h, test_common.cpp, test_crsf.cpp]
2026-11-14 RC_Common 1.3.0 mit 1.2.2 (getDuplicatePorts) zusammengefuehrt
    Gemeinsamer Stand fuer alle Kopien: 1.2.1 Chunk-Fix + 1.2.2 getDuplicatePorts + 1.3.0 Lua hidden.
    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
    [crsf_esp32.cpp, crsf_esp32.h, test_crsf.cpp]
2026-11-14 RC_Common 1.3.0: laeuft auch auf RP2350, .orig-Reste entfernt
    init_crsf/init_router und StatusLed nur bei ESP32, initializer_list in crsf_platform.h. Damit ist der RP2350-Auszug identisch.
    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
